woshinamoda/eCon_ArmLet/README.md

## 肌电臂环集合内容（包含老版和新版全部代码与原理图，详细说明请参考项目说明）
### 更新记录
---
更新日期：2022/08/30<br>
 * 1.修改存在的错别字
 * 2.新版臂环和老版臂环分隔开<br>
  本仓库只存储老版本肌电臂环程序与对应内容
---

更新日期：2022/08/29<br>

 * 1.新增修改github上关于肌电臂环梳理内容
 * 2.验证老版本臂环程序matlab内容<br>
  	修改对应老版臂环说明书
	* 详情参考 旧版肌电臂环全部内容<br>
				->重要文档
					—>《肌电臂环说明书V0.0.1》

---

### 项目说明
- doc：内部包含新版本肌电臂环工作计划与讨论的设计开发内容梳理
- Software：新版本肌电臂环程序，基于nrf52832设计
- Hardware：新版本肌电臂环原理图设计
- 旧版本肌电臂环全部内容
	* 1 ：20套肌电臂环单电源测试流程 ： 测试21年10月左右生产的臂环是否有问题
	* 2 : ARMletV0.0.0
	* 3 : ARMletV0.1.1
	* 4 : ARMletV0.1.2
	* 5 : ARMletV1.0.0	：	没有IMU程序
	* 6 : ARMletV1.0.1	：	发给字节跳动带有IMU的程序
	* 7 : BlurTooth_doc	：	飞易通和翌虹的蓝牙模块资料汇总
	* 8 : 肌电臂环生产检测入库文件
	* 9 : 测试流程18套成品肌电臂环
	* 10: matlab离线在线代码
		* 1-> read_data_offline.m ： 离线测试肌电臂环EMG与IMU 信号完整度的测试代码
		* 2-> read_data_online.m  ： 在线观察肌电臂环8个通道RMG与三个方向IMU 信号连续都的测试代码
	* 11: 重要文档
	* 12: read_data.m：用于检测老版本臂环功能的matlab代码
