woshinamoda/eCon_ArmLet/旧版本肌电臂环全部内容/肌电臂环资料(朝旭发的)/资料说明.txt

蓝牙2.0臂带主控板
肌电信号处理电路及PCB-->单个肌电模块电路，主板下的肌电模块电路
程序-->对应“蓝牙2.0臂带主控板”，用的标准库
PCB_SingleSupplyEMG-->最新的单个肌电模块电路，单电源供电
band4.0-->蓝牙4.0主控板和dongle
22、手环新版-->主控板有略微改动，程序用HAL库写了一遍
