woshinamoda/eCon_ArmLet/旧版本肌电臂环全部内容/20套肌电臂环单电源测试流程拟定/臂环测试流程修改3.1/肌电臂环--主板测试流程（GE修改20220224）.docx

# 调试检验规程

产品名称：肌电臂环----控制主板

产品版本：V0.1.4

### 1、 目的

入库检测流程。确保入库时排查出有问题的PCB

### 2、 范围

仅限于版本号：V0.1.4的控制主板


正面：


反面：

### 三、程序烧录

1）.测试控制主板的硬件焊接质量

A. 观察正面与反面，是否有元器件缺焊、漏焊的情况。没有视为正常情况
B. 在焊接的元器件上，观察主控芯片、姿态传感器、二极管、RGB灯充电和LDO芯 片是否存在焊接方向上的问题。与丝印标注一致视为焊接正常情况。对应有极性元 器件标注，如下图所示，红框部分都是需要注意的器件。

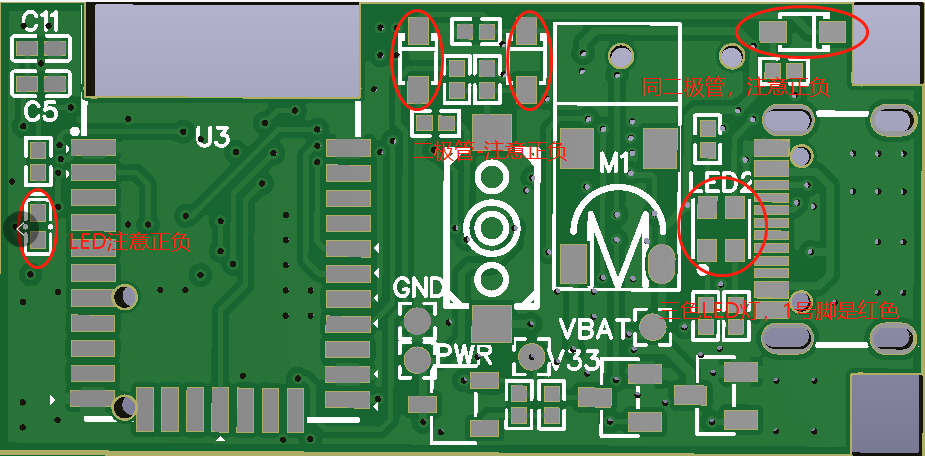
[picture p17: figure]

正面

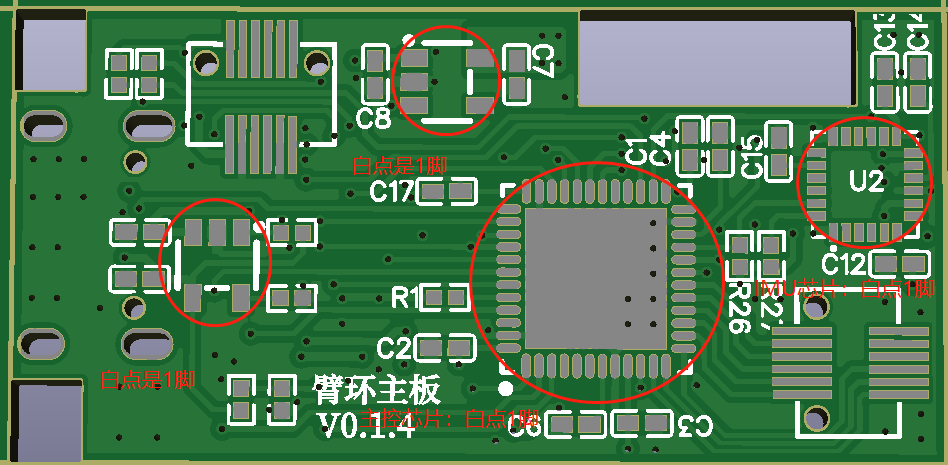
[picture p18: figure]

背面

C. 着重观察板对板连接器有无短路的情况，没有连锡或者短路，视为正常情况。
2） .电压检测
A. 在第一步检测没有短路情况下，控制主板上焊接好电池。电池电压范围在3.7V-4.2V 之间。
B. 长按按键，同时，用万用表测量直流挡点3.3V接入点。如果显示输出位3.3V，则视为正常电源。整体电源部分正常，下面可以写入程序进一步测试
3） 程序烧写
A. 准备一个ST-LINK和USB-TypeC公信号转接板
B. 把信号clk和dio和ST-link连接起来，插入控制主板后，烧入程序。连接后如图所 示。在烧录过程中，需要长按按键，保证LDO的使能引脚处于高电平状态。这样 可以保证MCU的VCC一直处于3.3V状态，可以顺利烧入程序


### 四、 硬件检测步骤

测试条件：在完成程序烧录，初步保证上电工作正常的情况下进行的硬件测试。测试主要验 证带电工作的情况下，元器件都处于正常工作情况。

1） . LED灯检测观察
A. 开机的瞬间，LED（蓝牙指示灯）灯显示蓝色。如果符合条件，视为正常
B. 开机的瞬间，RGB灯会显示白色，如果符合条件，视为正常。显示其他颜色可能是 部分颜色的缺失。
C. 开机后，RGB的颜色会依据当前电池电量显示对应颜色 <3.7V显示红色， ＞3.7V且 小于3.8V显示黄色， 大于3.8V显示蓝色
2） . 震动电机检测
A. 开机时，震动电机会工作200ms。
B. 关机时，震动电机会工作200ms。同时满足上述情况，视为正常。
3） . 充电检测
A. 正常情况下，RGB灯显示当前电量颜色，对应颜色 <3.7V显示红色， ＞3.7V且小于 3.8V显示黄色， 大于3.8V显示蓝色。接入充电器瞬间。蓝牙关闭，RGB灯显示绿 色闪烁状态。
B. 如果电池电压超过4.1V，RGB灯显示绿色常量状态。同时满足上述情况，视为充电 正常

4）. 开机检测

A. 在关机状态下，如果长按按键两秒。控制主板会进入开机提示，随后进入工作状态。
B. 在关机状态下，如果接入充电器。控制主板会进入开机提示，随后进入工作状态。

同时满足上述情况，视开机功能正常

5) . 关机检测
A. 在开机状态下，如果长按按键两秒。控制主板会进入关机提示，随后进入关机状态。
B. 在充电状态下，如果拔掉充电器。控制主板会进入关机提示，随后进入关机状态。

### 五、测试记录报告

小板检测表
方法分类 | 序号 | 内容 | 检测结果
焊接检测 | 1 | 有无缺焊、漏焊的情况
| 2 | 有无短路、焊接错误、元器件损坏或者翘起来的情况
| 3 | 有极性元器件是否方向摆放错误
| 4 | 板对板元器件确认是否焊接正常
电压测试 | 1 | 3.3V是否输出正常
| 2 | 充电时，5V接入和VBAT输出是否正常
程序测试 | 1 | LED与RGB状态是否正常
| 2 | 震动电机检测是否正常
| 3 | 充电检测是否正常
| 4 | 开机检测是否正常
| 5 | 关机检测是否正常
