woshinamoda/eCon_ArmLet/旧版本肌电臂环全部内容/肌电臂环资料(朝旭发的)/Newarm/线路图.pptx

Amp底板

Amplifier

3.3V转-Vs

板对板连接器

3.3V

3.7V

V1234 678

主板

3.7V转3.3V

3.7V充电

电池

Amplifier

3.7V

3.3V

-Vs

V1234 678
