woshinamoda/eCon_ArmLet/旧版本肌电臂环全部内容/重要文档/版本说明.docx

V0.1.1:

双电源原始版本

V0.1.2：

新增串口指令

0xCC 0xDD + 0xFF 0x66 //开启IMU读取

0xCC 0xDD + 0xFF 0x77 //关闭IMU读取

例如：/* CCDDFF66 开启读取IMU*/

0xCC 0xDD + 0xEE time //开启一次电机震动

//震动时间 time x 100(ms),time 1个字节时间

0 - 255

例如：/* CCDDEE03 震动300毫秒*/

V1.0.0:

更换蓝牙 EH-M17(舍去)，用BT966/BT986代替
