woshinamoda/eCon_ArmLet/旧版本肌电臂环全部内容/重要文档/臂环图.docx

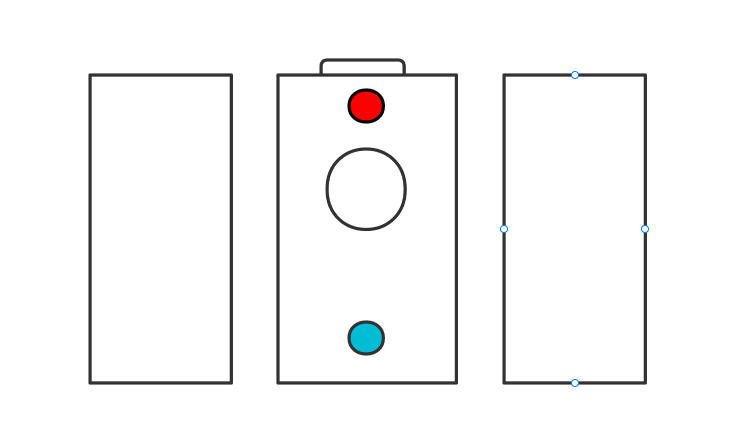
[picture p29: figure]

图5-1

j

i

h

g
