woshinamoda/eCon_ArmLet/旧版本肌电臂环全部内容/20套肌电臂环单电源测试流程拟定/臂环测试流程修改3.1/肌电臂环--小板测试流程（GE修改20220224）.docx

# 调试检验规程

产品名称：肌电臂环----采集小板

产品版本：V0.1.2

## 一、目的

入库检测流程。确保入库时排查出有问题的PCB

## 二、范围

仅限于版本号：V0.1.2的采集小板


接入测试点说明

1. 电池GND : 电池接入的负极
2. 电池输入+ : 电池接入的正极
3. GND测试点 : 引出的PCB的GND，方便电源信号测试
4. 3.3V接入点 : 运放供电输入，输入范围≤5V，测试时可用电池代替3.3V接入供电
5. 信号测试点 : 测试肌电信号

### 3、 测试步骤

1） .观察采集小板硬件焊接质量
A. 没有少元器件，没有漏焊的情况（注：NC处不用焊接）
B. 焊接的元器件没有翘起来、没有短路的情况
C. 正面两颗运放AD8607和INA826AIDR的1脚没有焊接反的情况。1脚标明如图所示红色方框处

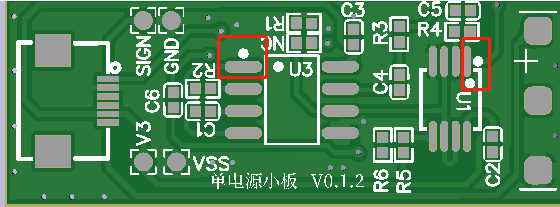
[picture p38: figure]

D. 反面的三个金属触电需要注意，有没有焊接不正的情况。如果明显可以看到有银白色焊盘露出，说明焊接不正。这种情况视为焊接失败。
2） .测试采集小板电路电压
A. 先用万用表蜂鸣挡测量GND与电池输入+、3.3V接入、信号测试点有无短路
B. 在执行完A且正常的情况下，测试员需要将电池的正极引线和3.3V接入点的测试焊盘焊接在一起，将电池的负极引线和GND测试点焊盘焊接在一起。为后面信号测试做准备。
3） .信号质量检测
A. 测试员将测试PCB的信号测试点与GND测试点用线焊接引出，与示波器相连接。如下图，GND引出线连接探头地，信号测试引出线连接探针夹处，如下图所示。


B. 测试PCB的底部金属用酒精擦拭，同时测试人员露出手臂，擦拭酒精。将金属部分和测试人员手臂紧密接触，用示波器观察波形。
1. 波形会有个直流基准电压，该电压电压值为二分之一的电池电压
2. 贴到手臂时，会有一个生物电波形。如果手臂处于静止状态，这个波形也稳定 的，没有过多的幅值变化。如下图所示

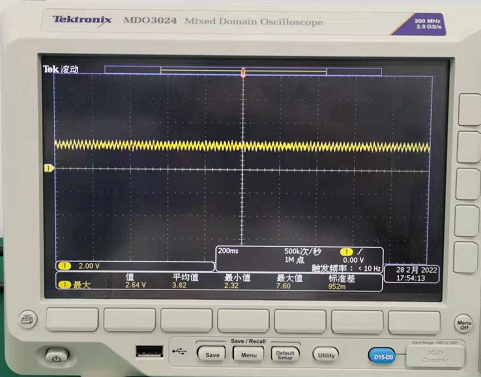
[picture p39: figure]

C. 随后测试人员请执行握拳，翻腕，伸张手掌等动作。观察有没有对应肌电波形产生。

波形如下图红圈部分所示。会有对应的动作电位波形产生。

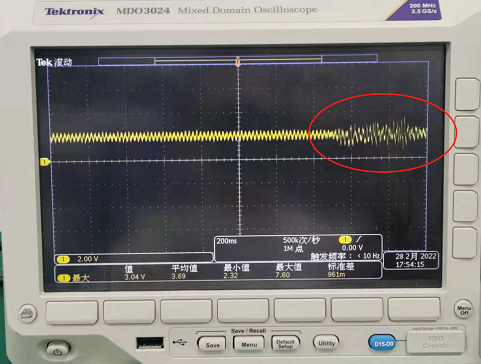
[picture p40: figure]

### 四、测试记录报告

小板检测表
方法分类 | 序号 | 内容 | 检测结果
焊接检测 | 1 | 有无缺焊、漏焊
| 2 | 有无短路、焊错、元器件损坏或翘起来
| 3 | 有极性元器件是否方向错误
| 4 | 关键元器(金属触电)件有无焊接不正的情况
电压测试 | 1 | 测试点有没有与GND短路的情况
信号测试 | 1 | 没有信号时观察波形，是否是直流VCC/2的电压。 如果是，说明运放工作正常。
| 2 | 采集信号是否正常，是否符合动作触发。符合触发视为采集工作正常
