woshinamoda/eCon_ArmLet/旧版本肌电臂环全部内容/臂环生产检测入库文件/肌电臂环主板BOOM清单.csv

ID | Name | Designator | Footprint | Quantity | Manufacturer Part | Manufacturer | Supplier | Supplier Part | Price
1 | MPU-6050_C24112 | U2 | QFN-24_L4.0-W4.0-P0.50-BL-MPU-6050 | 1 | MPU-6050 | InvenSense | LCSC | C24112 | 31.58
2 | 10k | R14,R19,R20,R24,R50 | R0402 | 5 | RT0402FRD0710KL | YAGEO | LCSC | C723584 | 0.0801
3 | 1uf | C17,C7,C8 | C0402_NEW | 3 | CL05B104KO5NNNC | SAMSUNG | LCSC | C1525 | 0.0068
4 | RT9013-12GB | U6 | SOT-23-5_L3.0-W1.7-P0.95-LS2.8-BR | 1 | RT9013-12GB | RICHTEK | LCSC | C58464 | 1.4209
5 | 104 | C1,C3,C6,C12,C13,C14,C2,C5 | C0402_NEW | 8 | CL05B104KO5NNNC | SAMSUNG | LCSC | C1525 | 0.0068
6 | 2.2uf | C4,C15 | C0402_NEW | 2 | CL05B104KO5NNNC | SAMSUNG | LCSC | C1525 | 0.0068
7 | 10kΩ | R1,R26,R27,R3,R15 | R0402 | 5 | RT0402FRD0710KL | YAGEO | LCSC | C723584 | 0.0801
8 | 2K | R7,R13 | R0402 | 2 | RT0402FRD0710KL | YAGEO | LCSC | C723584 | 0.0801
9 | STM32F411CEU6 | U1 | UFQFPN-48_L7.0-W7.0-P0.50-BL-EP | 1 | STM32F411CEU6 | STMicroelectronics | LCSC | C60420 | 38.78
10 | MCP73831T-2ACI/OT | U4 | SOT-23-5_L3.0-W1.7-P0.95-LS2.8-BR | 1 | MCP73831T-2ACI/OT | Microchip Tech | LCSC | C424093 | 7.94
11 | Header 12 | P1,P2 | BTB0.5*2*6BOTTOM | 2
12 | 4.7uf | C9,C10 | C0402_NEW | 2 | CL05B104KO5NNNC | SAMSUNG | LCSC | C1525 | 0.0068
13 | 20k | R16,R23 | R0402 | 2 | RT0402FRD0710KL | YAGEO | LCSC | C723584 | 0.0801
14 | 1.2mm测试点 | GND,PWR,V33,VBAT | 1.2毫米测试点 | 4
15 | BL-HB337A-AV-TRB | LED1 | LED0402-RD | 1 | BL-HB337A-AV-TRB | BrtLed | LCSC | C165977 | 0.1896
16 | FM-B2020RGBA-HG | LED2 | LED-SMD_FM-B2020RGBA-HG | 1 | FM-B2020RGBA-HG | NATIONSTAR | LCSC | C108793 | 0.1843
17 | 510ohm | R2 | R0402 | 1 | RT0402FRD0710KL | YAGEO | LCSC | C723584 | 0.0801
18 | FSC-BT982 | U3 | WIFI-SMD_FAKRAZ180 | 1 | FSC-BT982 | null | LCSC | C9900002352
19 | 1N4148WS T4 | D3,D1,D2 | SOD-323_L1.8-W1.3-LS2.5-RD | 3 | 1N4148WS T4 | CJ | LCSC | C2128 | 0.1045
20 | 1M | R5 | R0402 | 1 | RT0402FRD0710KL | YAGEO | LCSC | C723584 | 0.0801
21 | NPN | Q3,Q1 | SOT-23-3_L2.9-W1.3-P1.90-LS2.4-BR | 2 | DTC143ZCA | CJ | LCSC | C15236 | 0.1601
22 | PMOS | Q2 | SOT-23-3_L2.9-W1.6-P1.90-LS2.8-BR | 1 | BLM3401 | BL | LCSC | C90479 | 0.4747
23 | 106 | C11 | C0402_NEW | 1 | CL05B104KO5NNNC | SAMSUNG | LCSC | C1525 | 0.0068
24 | 510 | R21,R22,R25,R29 | R0402 | 4 | RT0402FRD0710KL | YAGEO | LCSC | C723584 | 0.0801
25 | KH-TYPE-C-16P | USB1 | USB-C-SMD_KH-TYPE-C-16P | 1 | KH-TYPE-C-16P | Shenzhen Kinghelm Elec | LCSC | C709357 | 0.5965
26 | KEY | SW1 | KEY-SMD_L6.2-W3.6-LS8.0 | 1 | K2-1107ST-A4SW-06 | Rectangular Connectors - Contacts | LCSC | C118141 | 0.4502
27 | MOTOR | M1 | MOTOR | 1
