woshinamoda/eCon_ArmLet/旧版本肌电臂环全部内容/肌电臂环资料(朝旭发的)/Newarm/HandBand_HW/HW2.0/band4.1.dxf

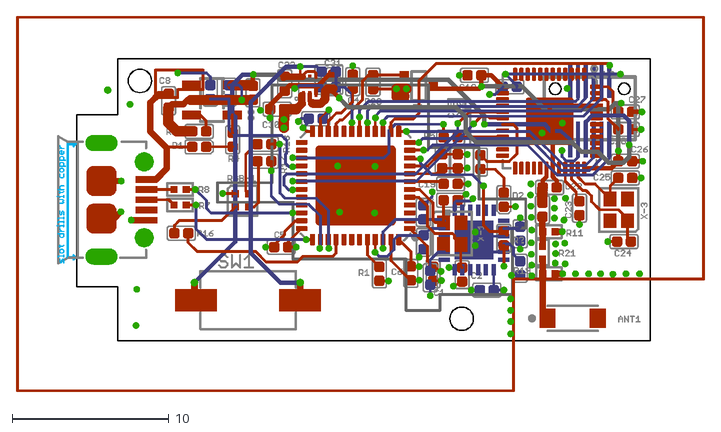
[picture p45: CAD file, 2022-08-29, an earlier design]
旧版本肌电臂环全部内容/肌电臂环资料(朝旭发的)/Newarm/HandBand_HW/HW2.0/band4.1.dxf
44.0 x 24.0
