woshinamoda/eCon_ArmLet/旧版本肌电臂环全部内容/肌电臂环资料(朝旭发的)/肌电信号处理电路及PCB/肌电信号处理电路及PCB/PCB finished/testing.PcbDoc.htm

Reporting Options

# File in Previous Format

Date | : | 2020-03-25
Time | : | 15:06:13
Filename | : | F:\DeskManager\2、手环程序+硬件\肌电信号处理电路及PCB\肌电信号处理电路及PCB\PCB finished\testing.PcbDoc

Version | Warning
Release 12 | CAUTION - Air Gap Width previously controlled by Clearance rule is now controlled by Polygon Connect Style rule's newly introduced Air Gap Width (set to default value). Suggest reviewing each Polygon Connect Style rule's Air Gap Width attribute for correctness.
Release 13 | CAUTION - Silkscreen Over Component Pads Rules are converted to Silk To Solder Mask Clearance Rules. Suggest examining rule scopes for accuracy.

This file was generated by an earlier version of the software
