woshinamoda/eCon_ArmLet/旧版本肌电臂环全部内容/肌电臂环资料(朝旭发的)/程序/日志.txt

20170305:
目标：本工程实现mpu上的dmp读取和四元数解算
20170312：
已基本实现读取和四元数的读取，现有算法能实现
实现四元素和欧拉角的转换
现存问题：mpu的响应较慢，即得到正确的欧拉角要很长时间
20170426:
1）发现了mpu9150读空的现象，导致数据不连续的问题
