woshinamoda/eCon_ArmLet/旧版本肌电臂环全部内容/肌电臂环资料(朝旭发的)/肌电信号处理电路及PCB/肌电信号处理电路及PCB/testing/testing.pdf

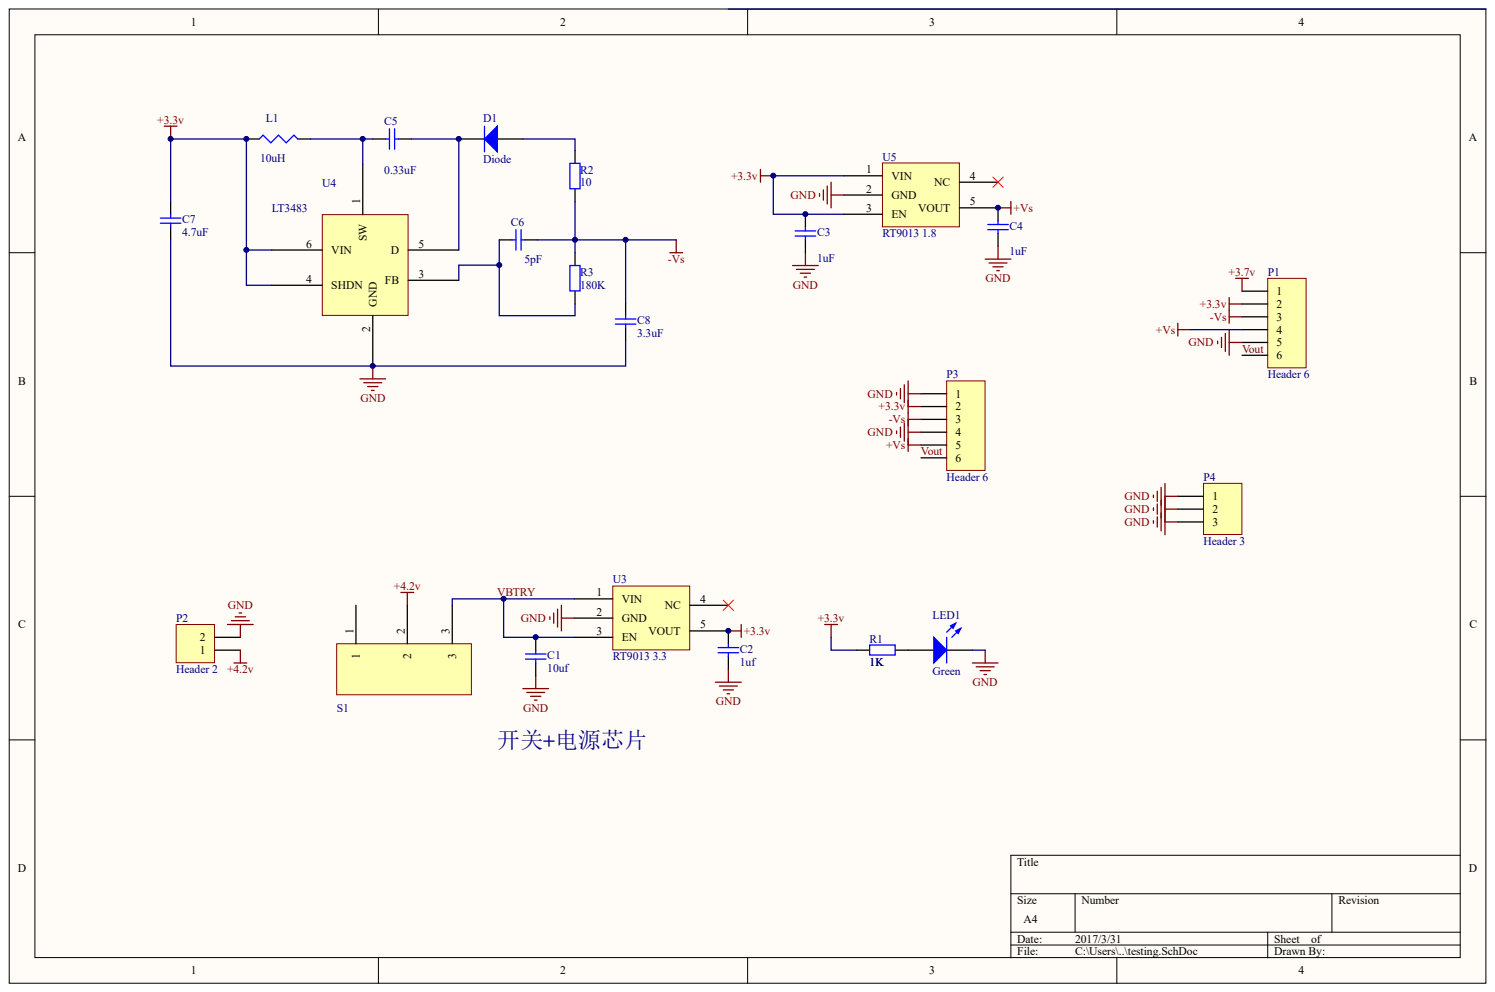
[picture p46: page 1]

GND 2
EN 3
