woshinamoda/eCon_ArmLet/旧版本肌电臂环全部内容/肌电臂环资料(朝旭发的)/band4.0-蓝牙的主从/slave/band4.0.pdf

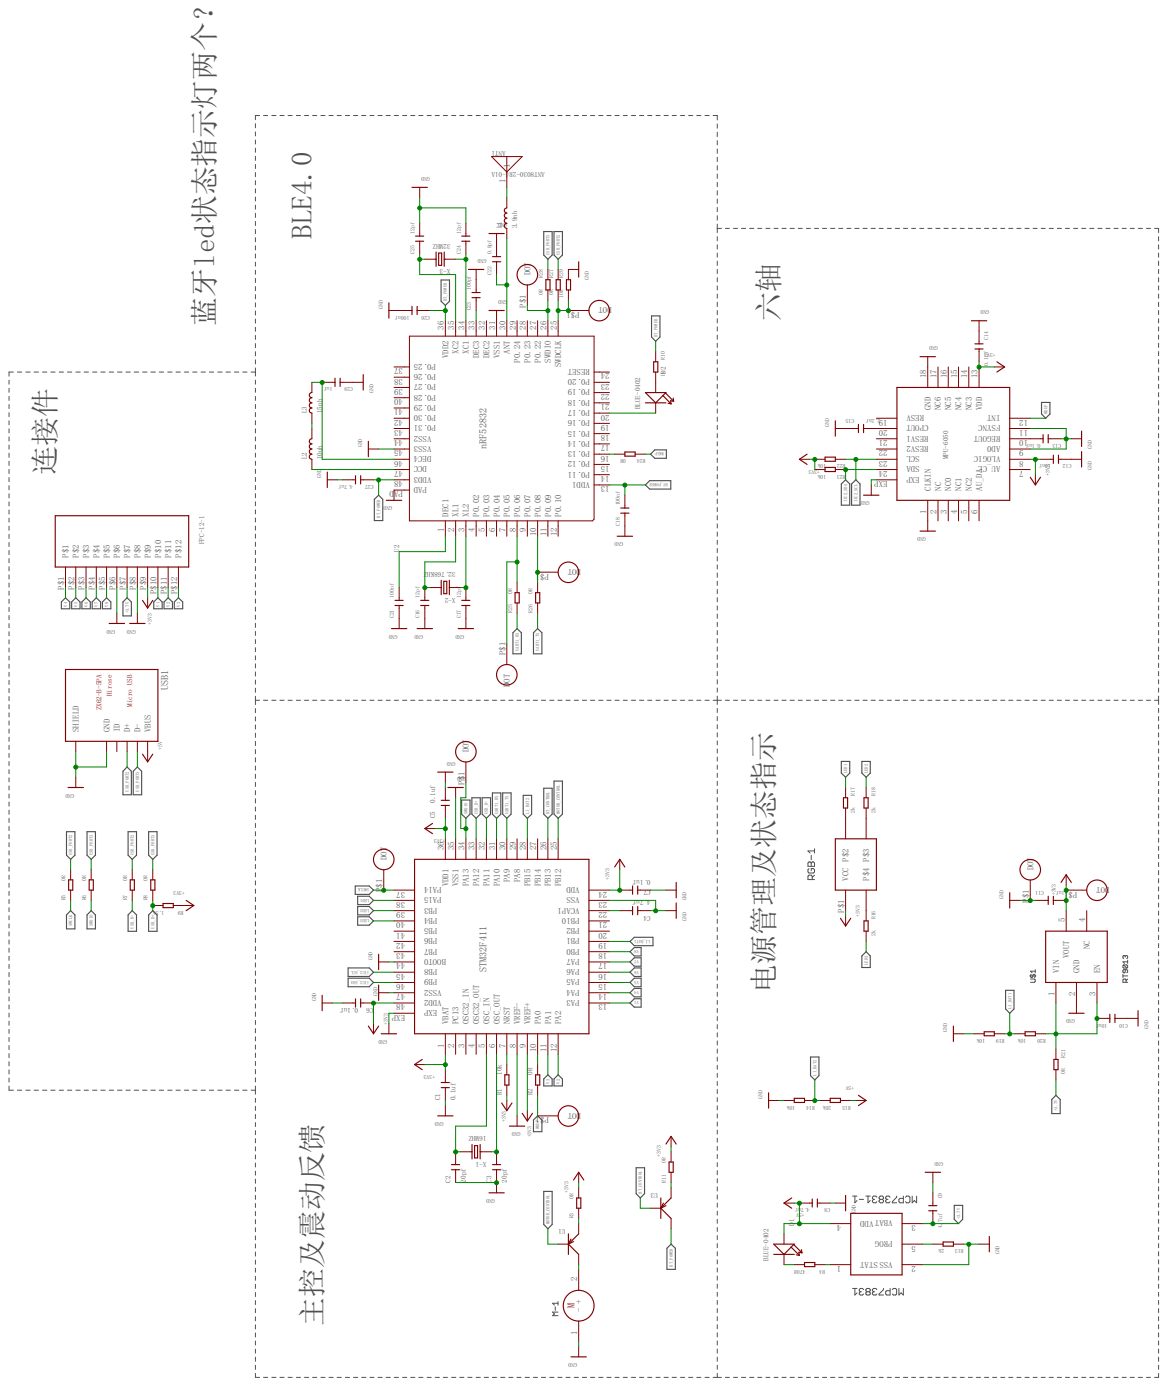
[picture p47: page 1]

主控及震动反馈 电源管理及状态指示 六轴 蓝牙led状态指示灯两个？ BLE4.0 连接件 STM32F411 MPU-6050 nRF52832 0.1uf 20pf 20pf fu7.4 0.1uf fu1.0 ZHM61 DNG DNG DNG DNG GND GND 3V3+ +3V3 +3V3 3V3+ +3V3 10k 0R 0R fu1.0 DNG GND GND GND +3V3 DNG +3V3 DNG BLUE-0402 R074 V5+ fu7.4 GND GNk2 D 4.7uf DNG k01 k02 GND V5+ +3V3 2k 2k2k k01 k01 0R GND DNG fu01 GND fu1 GND+3V3 BLUE-0402 fn01 fu1.0 0.1uf fn2.2 k01 k01 DNG DNG +3V3GND GND DNG3V3+ DNG GND 3V3+ 12pf 12pf 100nf 100nf ZHK867.23 R0 0R0R DNG DNG DNG DNG 0R0R 10k 0.8pf 100pf 12pf 12pf fn001 GND 3.9nh 10uh 15nh A10-4R2-0308TNA DNG DNG DNG ZHM23 GND DNG fu7.4 GND DNG fu1 GND GND DNG DNG +3V3 +5V DNG 0R0R0R0R k5.1 3V3+ +3V3 1k 0R VBAT 1 PC13 2 OSC32_IN 3 OSC32_OUT 4 OSC_IN 5 OSC_OUT 6 NRST 7 VREF- 8 VREF+ 9 PA0 10 PA1 11 PA2 12 3AP 31 4AP 41 5AP 51 6AP 61 7AP 71 0BP 81 1BP 91 2BP 02 01BP 12 1PACV 22 SSV 32 DDV 42 PB12 25 PB13 26 PB14 27 PB15 28 PA8 29 PA9 30 PA10 31 PA11 32 PA12 33 PA13 34 VSS1 35 VDD1 36 41AP 73 51AP 83 3BP 93 4BP 04 5BP 14 6BP 24 7BP 34 0TOOB 44 8BP 54 9BP 64 2SSV 74 2DDV 84 PXE PXE C1 C2C3 4C C5 6C 1-X R1R2 R3 7C - 1 + 2 1U TATS 1 SSV 2 TABV 3 DDV 4 GORP 5 VIN 1 GND 2 EN 3 NC 4 VOUT 5 VCC P$1 P$2 P$3 P$4 D1 4R8C 31R C9 41R 51R R16 R17 R18 91R 02R R21 01C 11C D2 CLKIN 1 NC 2 NC0 3 NC1 4 NC2 5 AU_DA 6 LC_UA 7 CIGOLV 8 0DA 9 TUOGER 01 CNYSF 11 TNI 21 VDD 13 NC3 14 NC4 15 NC5 16 NC6 17 GND 18 VSER 91 TUOPC 02 1VSER 12 2VSER 22 LCS 32 ADS 42 PXE PXE 21C 31C C14 51C 22R 32R 72.0P 93 XL1 2 XL2 3 P0.23 28 P0.22 27 P0.02 4 P0.03 5 P0.04 6 P0.05 7 P0.06 8 P0.07 9 TESER 42 1DDV 31 P0.08 10 P0.09 11 P0.10 12 11.0P 41 21.0P 51 31.0P 61 41.0P 71 51.0P 81 61.0P 91 SWDIO 26 SWDCLK 25 71.0P 02 81.0P 12 91.0P 22 02.0P 32 P0.24 29 ANT 30 VSS1 31 DEC2 32 DEC3 33 52.0P 73 62.0P 83 VDD2 36 XC1 34 XC2 35 DEC1 1 DAP DAP 82.0P 04 92.0P 14 03.0P 24 13.0P 34 2SSV 44 3SSV 54 4CED 64 CCD 74 3DDV 84U2 C16 C17 C18 C21 2-X 42R R25 R26 R27 R28 R29C22 C23 C24 C25 62C L1 L2 L3 1 1 1TNA 3-X 72C 82C P$1 P$1 P$2 P$2 P$3 P$3 P$4 P$4 P$5 P$5 P$6 P$6 P$7 P$7 P$8 P$8 P$9 P$9 P$10 P$10 P$11 P$11 P$12 P$12 FPC-12-1 USB1 VBUS D-D+IDGND SHIELD R5R6R7R8 9R DOT P$1 DOT P$1 TOD 1$P TOD 1$P DOT P$1 DOT P$1 TOD 1$P TOD 1$P DOT P$1 3U R10 R11 WKUP WKUP PUKW V3 V3 V2 V2 1V V1 4V V4 5V V5 6V V6 7V V7 8V V8 1TAB_IL LI_BAT1 MOTOR_CONTROL MOTOR_CONTROL LI_BAT2 LI_BAT2 UART1_TX UART1_TX UART1_RX UART1_RX USB_D- USB_D- USB_D+ USB_D+ SWDIO SWDIO KLCWS SWCLK 1DEL LED1 2DEL LED2 3DEL LED3 LCS_2CII IIC2_SCL ADS_2CII IIC2_SDA +3.7V +3.7V +3.7V REWOP_TB BT_POWER BT_POWER BT_POWER BT_POWER USB_PORT2 USB_PORT2 USB_PORT2 USB_PORT2 USB_PORT3 USB_PORT3 USB_PORT3 USB_PORT3 BT_CONTROL BT_CONTROL M Micro USB Hirose ZX62-B-5PA
