woshinamoda/eCon_ArmLet/旧版本肌电臂环全部内容/肌电臂环资料(朝旭发的)/蓝牙2.0臂带主控板/Alpha-1.pdf

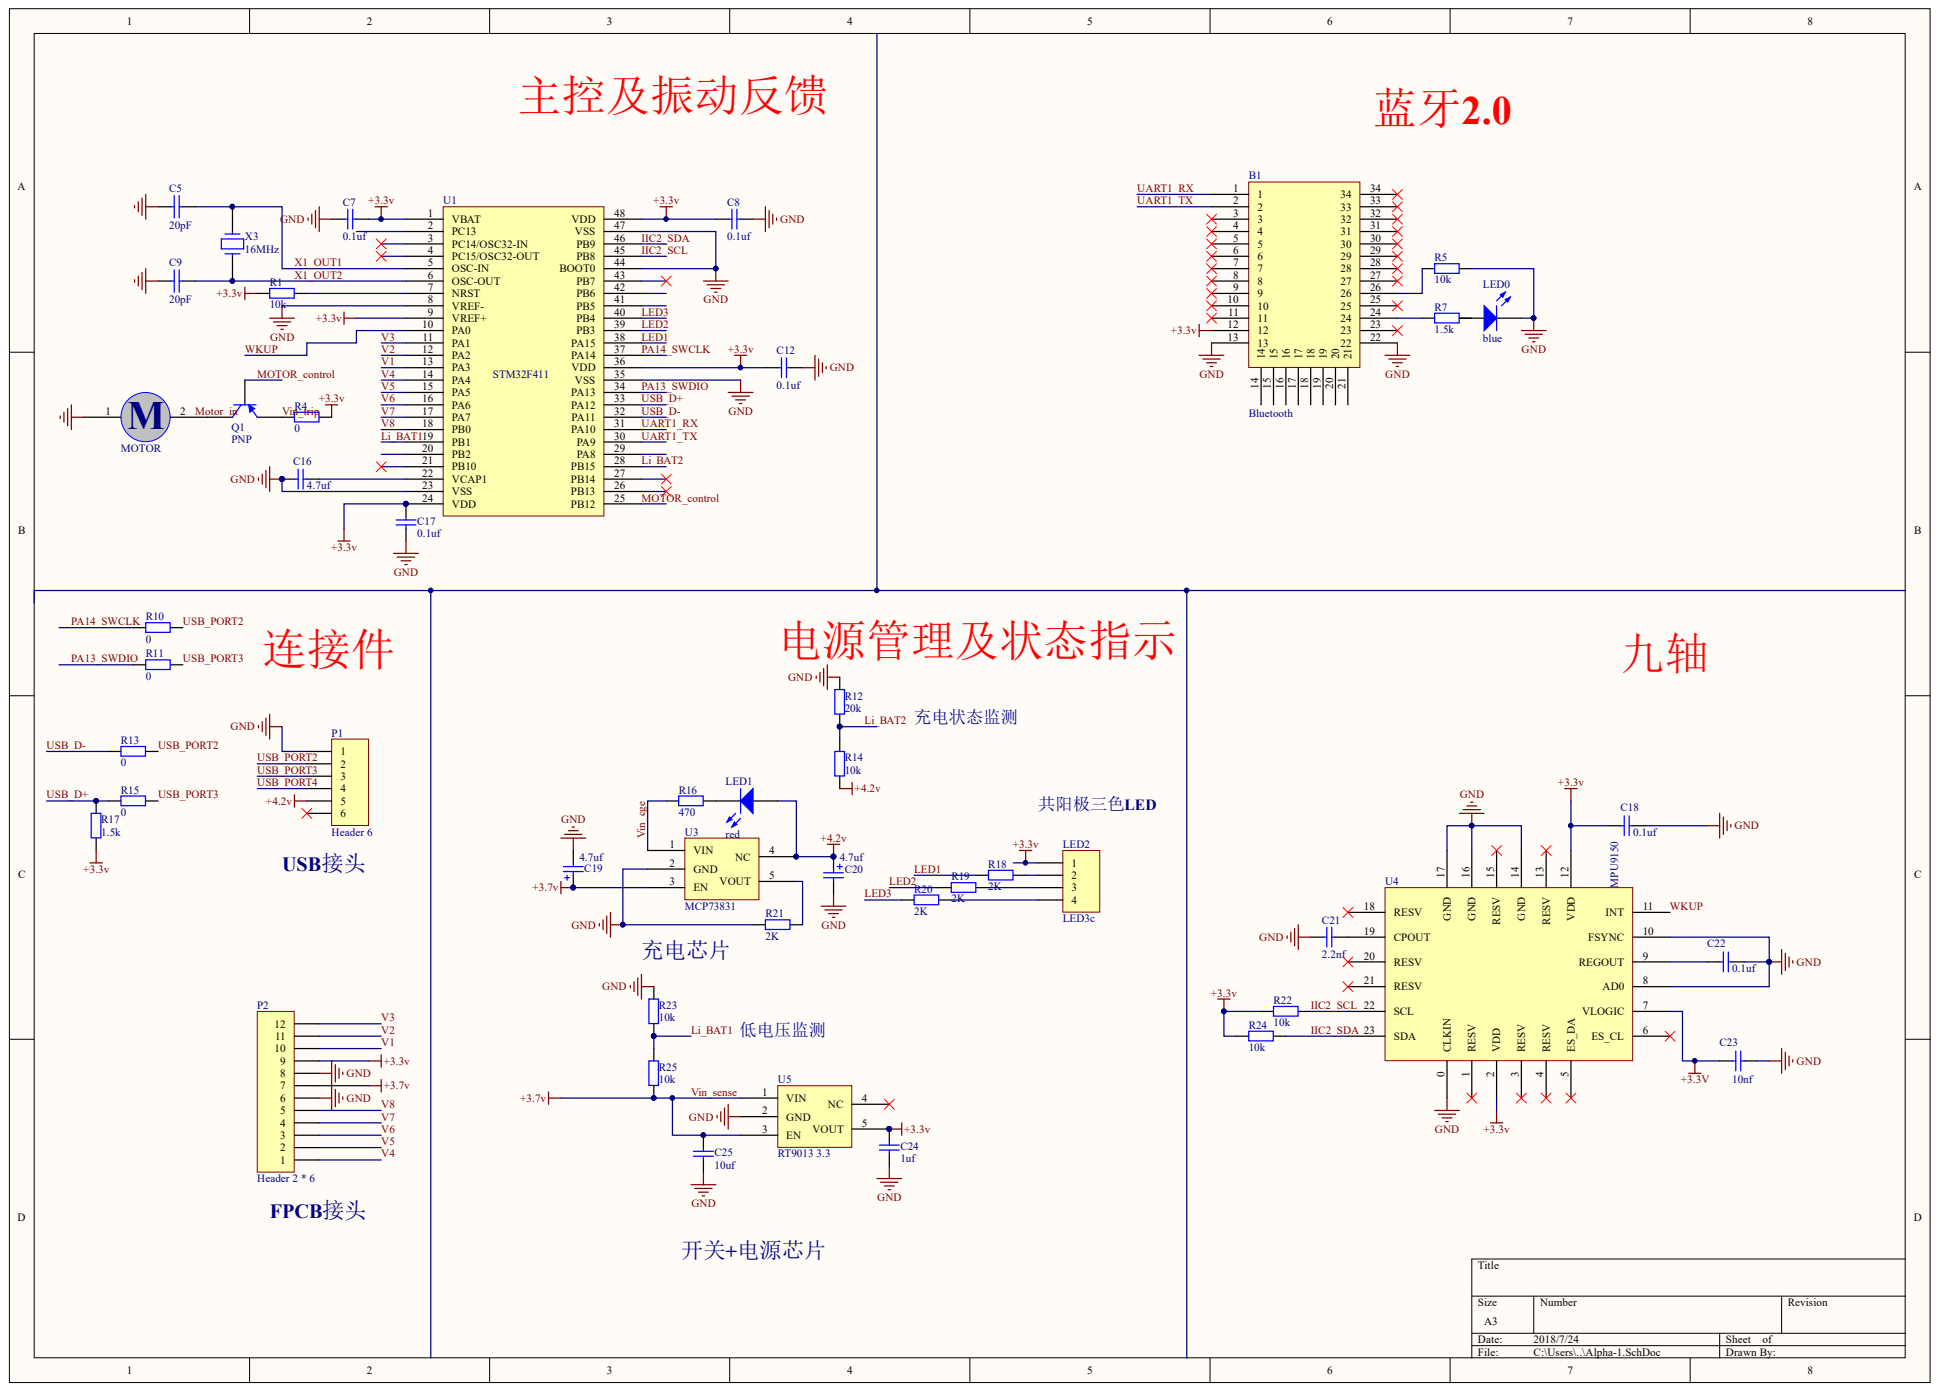
[picture p48: page 1]
