woshinamoda/eCon_ArmLet/旧版本肌电臂环全部内容/肌电臂环资料(朝旭发的)/band4.0-蓝牙的主从/host/host.pdf

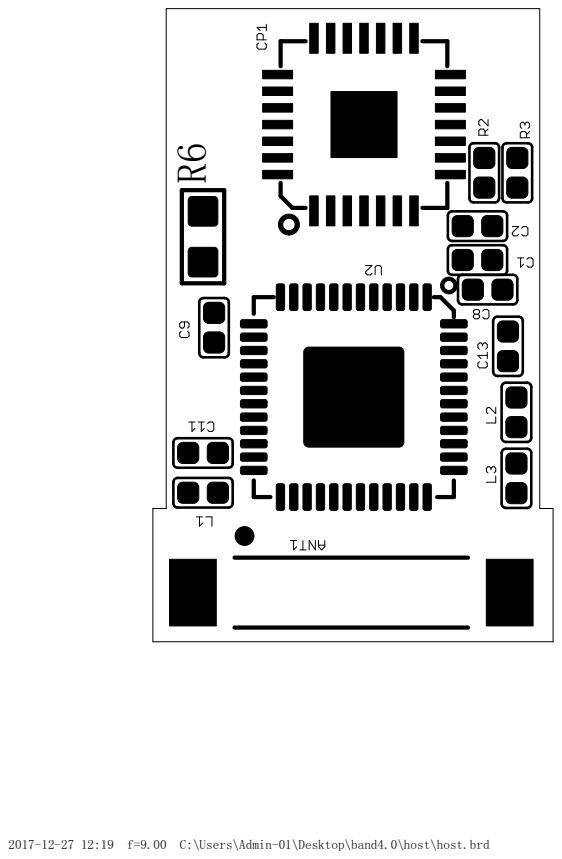
[picture p49: page 1]

2017-12-27 12:19 f=9.00 C:\Users\Admin-01\Desktop\band4.0\host\host.brd
