woshinamoda/eCon_ArmLet/旧版本肌电臂环全部内容/肌电臂环资料(朝旭发的)/肌电信号处理电路及PCB/肌电信号处理电路及PCB/amplifier/amplifier.pdf

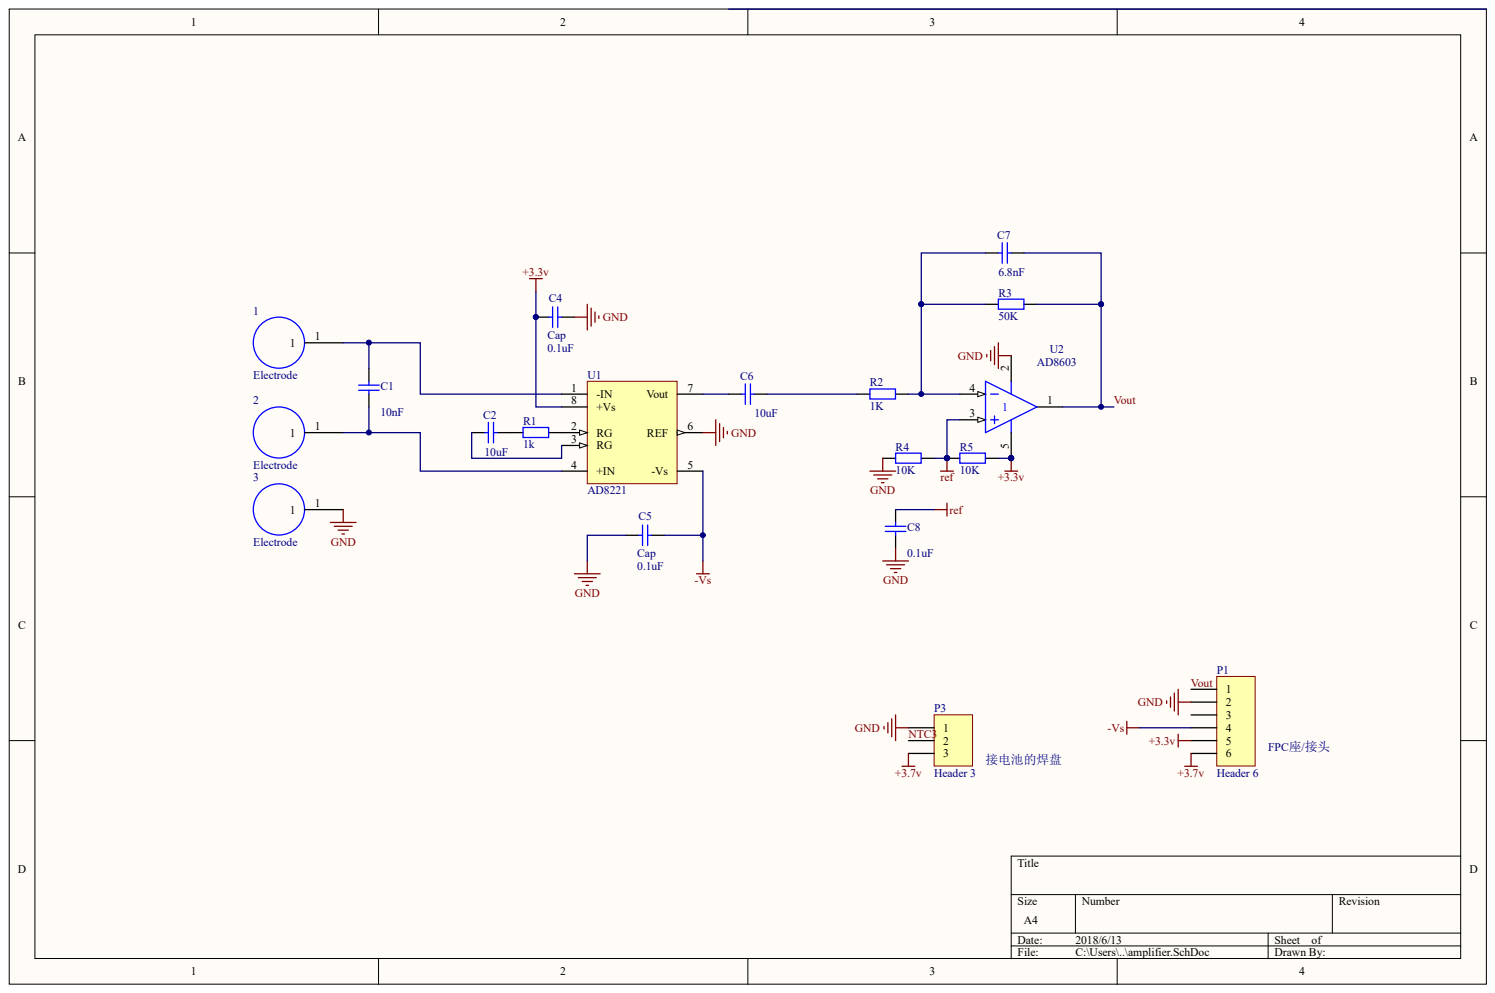
[picture p50: page 1]
