woshinamoda/eCon_ArmLet/(list of files, drawings)

Other design files:
旧版本肌电臂环全部内容/肌电臂环资料(朝旭发的)/肌电信号处理电路及PCB/肌电信号处理电路及PCB/amplifier sp/amplifier sp ref.PcbDoc
旧版本肌电臂环全部内容/肌电臂环资料(朝旭发的)/肌电信号处理电路及PCB/肌电信号处理电路及PCB/amplifier sp/amplifier sp.PcbDoc
旧版本肌电臂环全部内容/肌电臂环资料(朝旭发的)/肌电信号处理电路及PCB/肌电信号处理电路及PCB/amplifier sp/amplifier sp.PrjPCB
旧版本肌电臂环全部内容/肌电臂环资料(朝旭发的)/肌电信号处理电路及PCB/肌电信号处理电路及PCB/amplifier sp/amplifier sp.SchDoc
旧版本肌电臂环全部内容/肌电臂环资料(朝旭发的)/肌电信号处理电路及PCB/肌电信号处理电路及PCB/amplifier/amplifier1.PcbLib
旧版本肌电臂环全部内容/肌电臂环资料(朝旭发的)/肌电信号处理电路及PCB/肌电信号处理电路及PCB/amplifier/amplifier2.PcbLib
旧版本肌电臂环全部内容/肌电臂环资料(朝旭发的)/肌电信号处理电路及PCB/肌电信号处理电路及PCB/amplifier/amplifier3.PcbLib
旧版本肌电臂环全部内容/肌电臂环资料(朝旭发的)/肌电信号处理电路及PCB/肌电信号处理电路及PCB/amplifier/amplifier.PcbDoc
旧版本肌电臂环全部内容/肌电臂环资料(朝旭发的)/肌电信号处理电路及PCB/肌电信号处理电路及PCB/amplifier/amplifier.PcbLib
旧版本肌电臂环全部内容/肌电臂环资料(朝旭发的)/肌电信号处理电路及PCB/肌电信号处理电路及PCB/amplifier/amplifier.PrjPCB
旧版本肌电臂环全部内容/肌电臂环资料(朝旭发的)/肌电信号处理电路及PCB/肌电信号处理电路及PCB/amplifier/amplifier.SchDoc
旧版本肌电臂环全部内容/肌电臂环资料(朝旭发的)/肌电信号处理电路及PCB/肌电信号处理电路及PCB/PCB finished/amplifier sp.PcbDoc
旧版本肌电臂环全部内容/肌电臂环资料(朝旭发的)/肌电信号处理电路及PCB/肌电信号处理电路及PCB/PCB finished/amplifier.PcbDoc
旧版本肌电臂环全部内容/肌电臂环资料(朝旭发的)/肌电信号处理电路及PCB/肌电信号处理电路及PCB/PCB finished/testing.PcbDoc
旧版本肌电臂环全部内容/肌电臂环资料(朝旭发的)/肌电信号处理电路及PCB/肌电信号处理电路及PCB/testing/PCB_Project1.PrjPCB
旧版本肌电臂环全部内容/肌电臂环资料(朝旭发的)/肌电信号处理电路及PCB/肌电信号处理电路及PCB/testing/testing.PcbDoc
旧版本肌电臂环全部内容/肌电臂环资料(朝旭发的)/肌电信号处理电路及PCB/肌电信号处理电路及PCB/testing/testing.SchDoc
旧版本肌电臂环全部内容/肌电臂环资料(朝旭发的)/肌电信号处理电路及PCB/肌电信号处理电路及PCB/有线肌电模块/amp.PcbDoc
旧版本肌电臂环全部内容/肌电臂环资料(朝旭发的)/肌电信号处理电路及PCB/肌电信号处理电路及PCB/有线肌电模块/amp.PcbLib
旧版本肌电臂环全部内容/肌电臂环资料(朝旭发的)/肌电信号处理电路及PCB/肌电信号处理电路及PCB/有线肌电模块/amp.SchDoc
旧版本肌电臂环全部内容/肌电臂环资料(朝旭发的)/蓝牙2.0臂带主控板/Alpha-1.PcbDoc
旧版本肌电臂环全部内容/肌电臂环资料(朝旭发的)/蓝牙2.0臂带主控板/Alpha-1.PcbLib
旧版本肌电臂环全部内容/肌电臂环资料(朝旭发的)/蓝牙2.0臂带主控板/Alpha-1.SchDoc
