woshinamoda/eCon_ArmLet/旧版本肌电臂环全部内容/肌电臂环资料(朝旭发的)/band4.0-蓝牙的主从/slave/band4.0.brd

## EAGLE design 旧版本肌电臂环全部内容/肌电臂环资料(朝旭发的)/band4.0-蓝牙的主从/slave/band4.0.brd (2022-08-29, an earlier design)

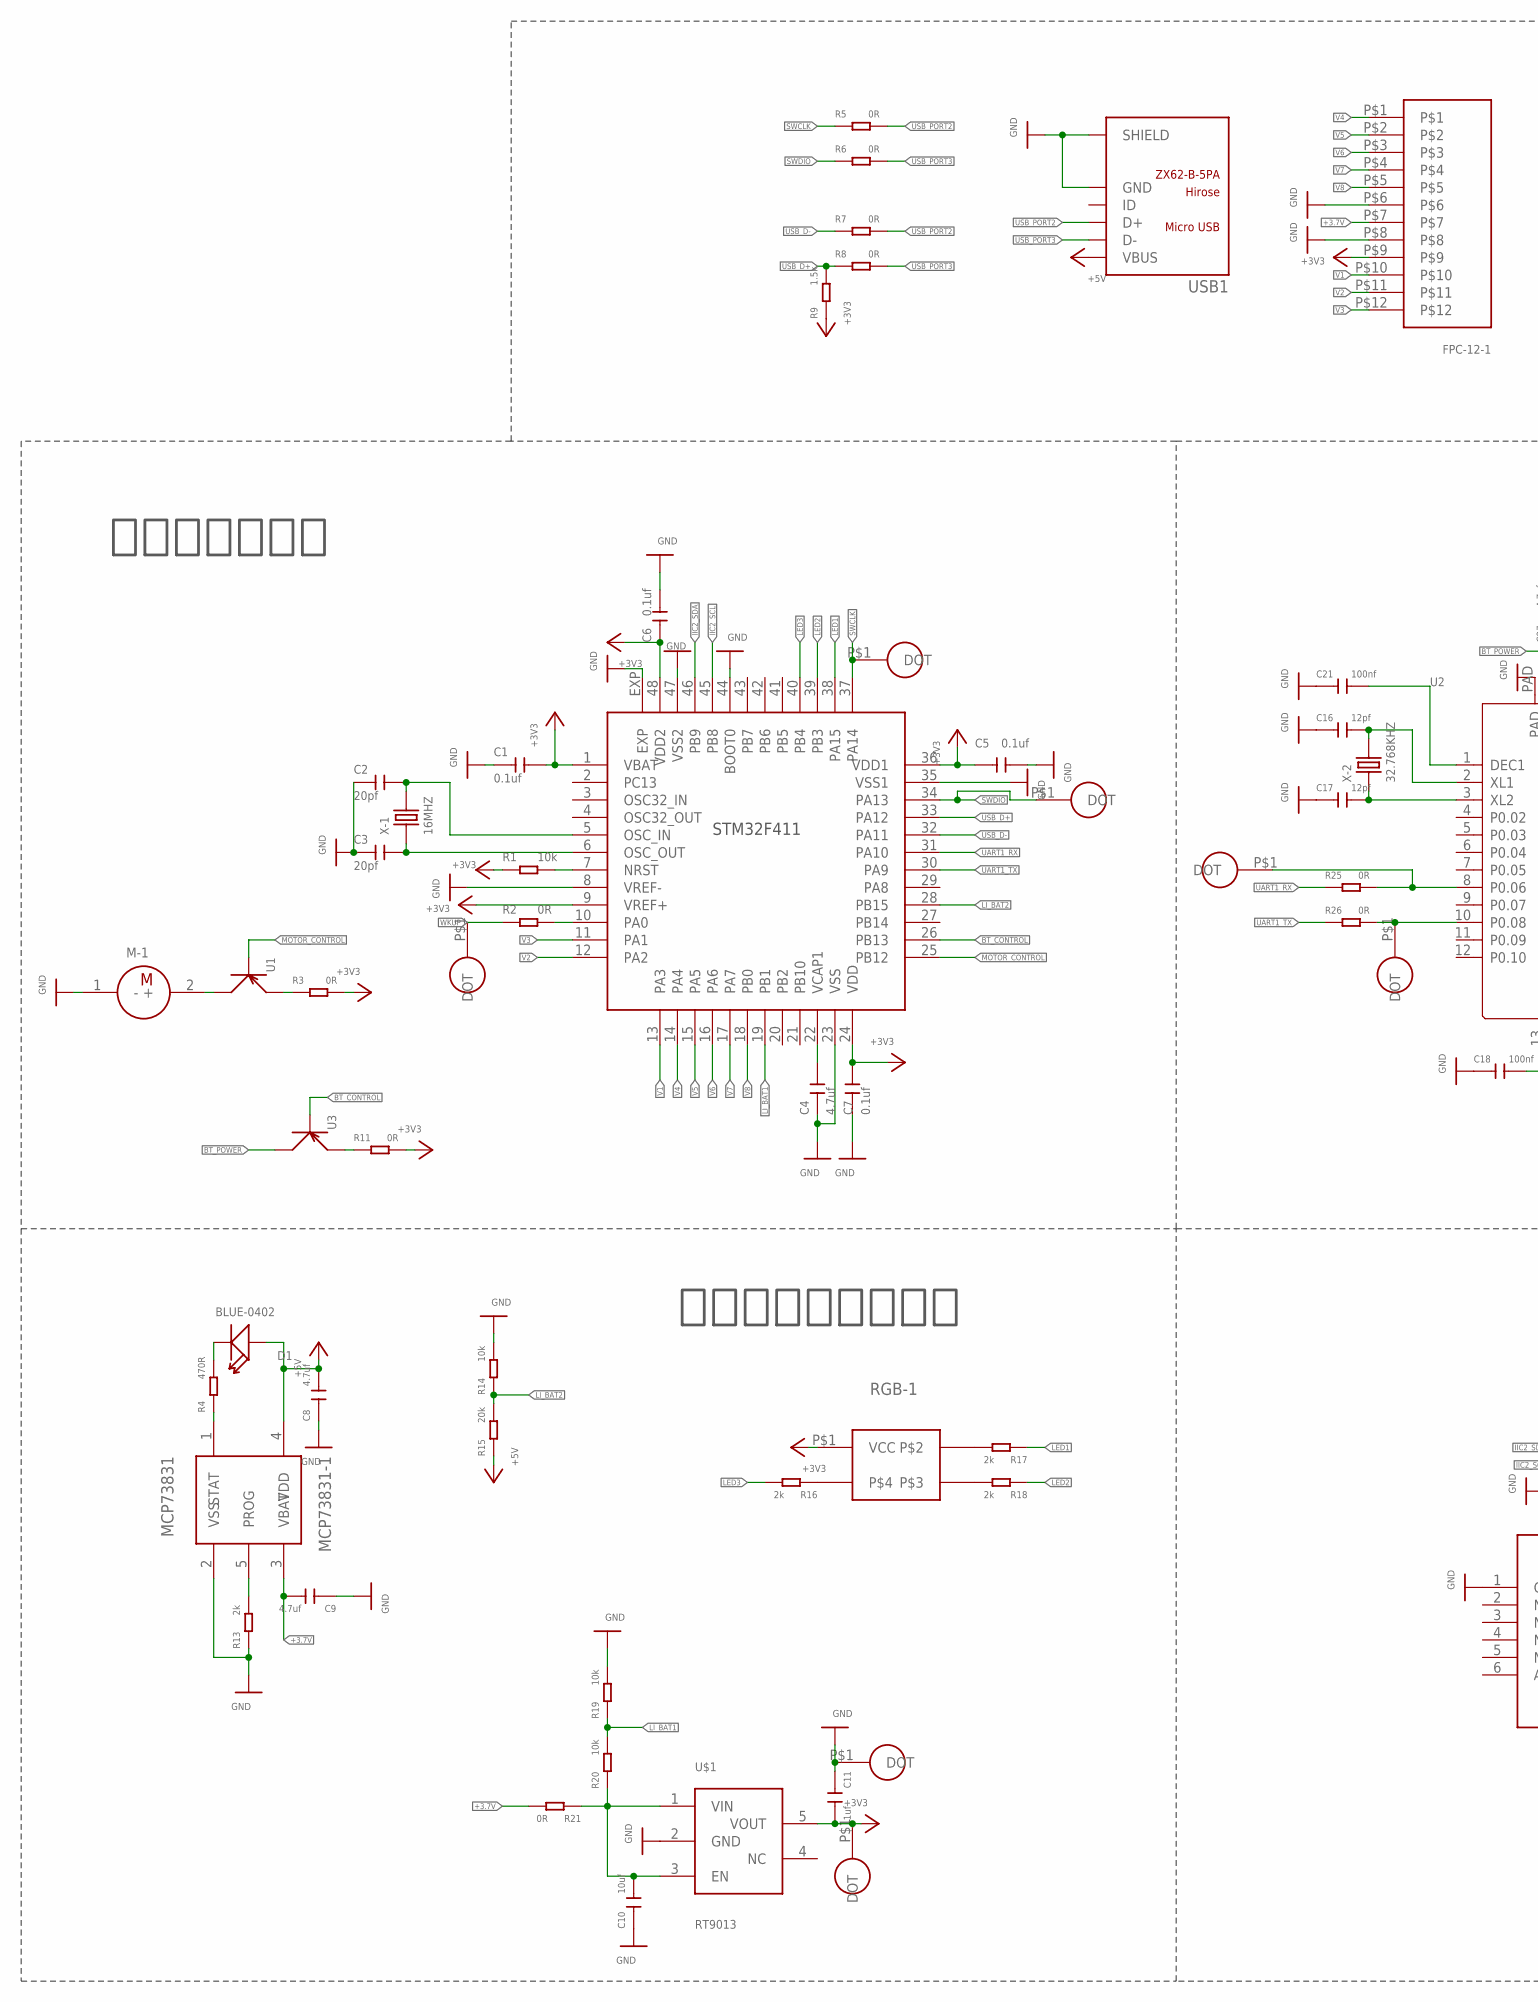
[picture p51: schematic band4.0.sch, part in row 1, column 1]

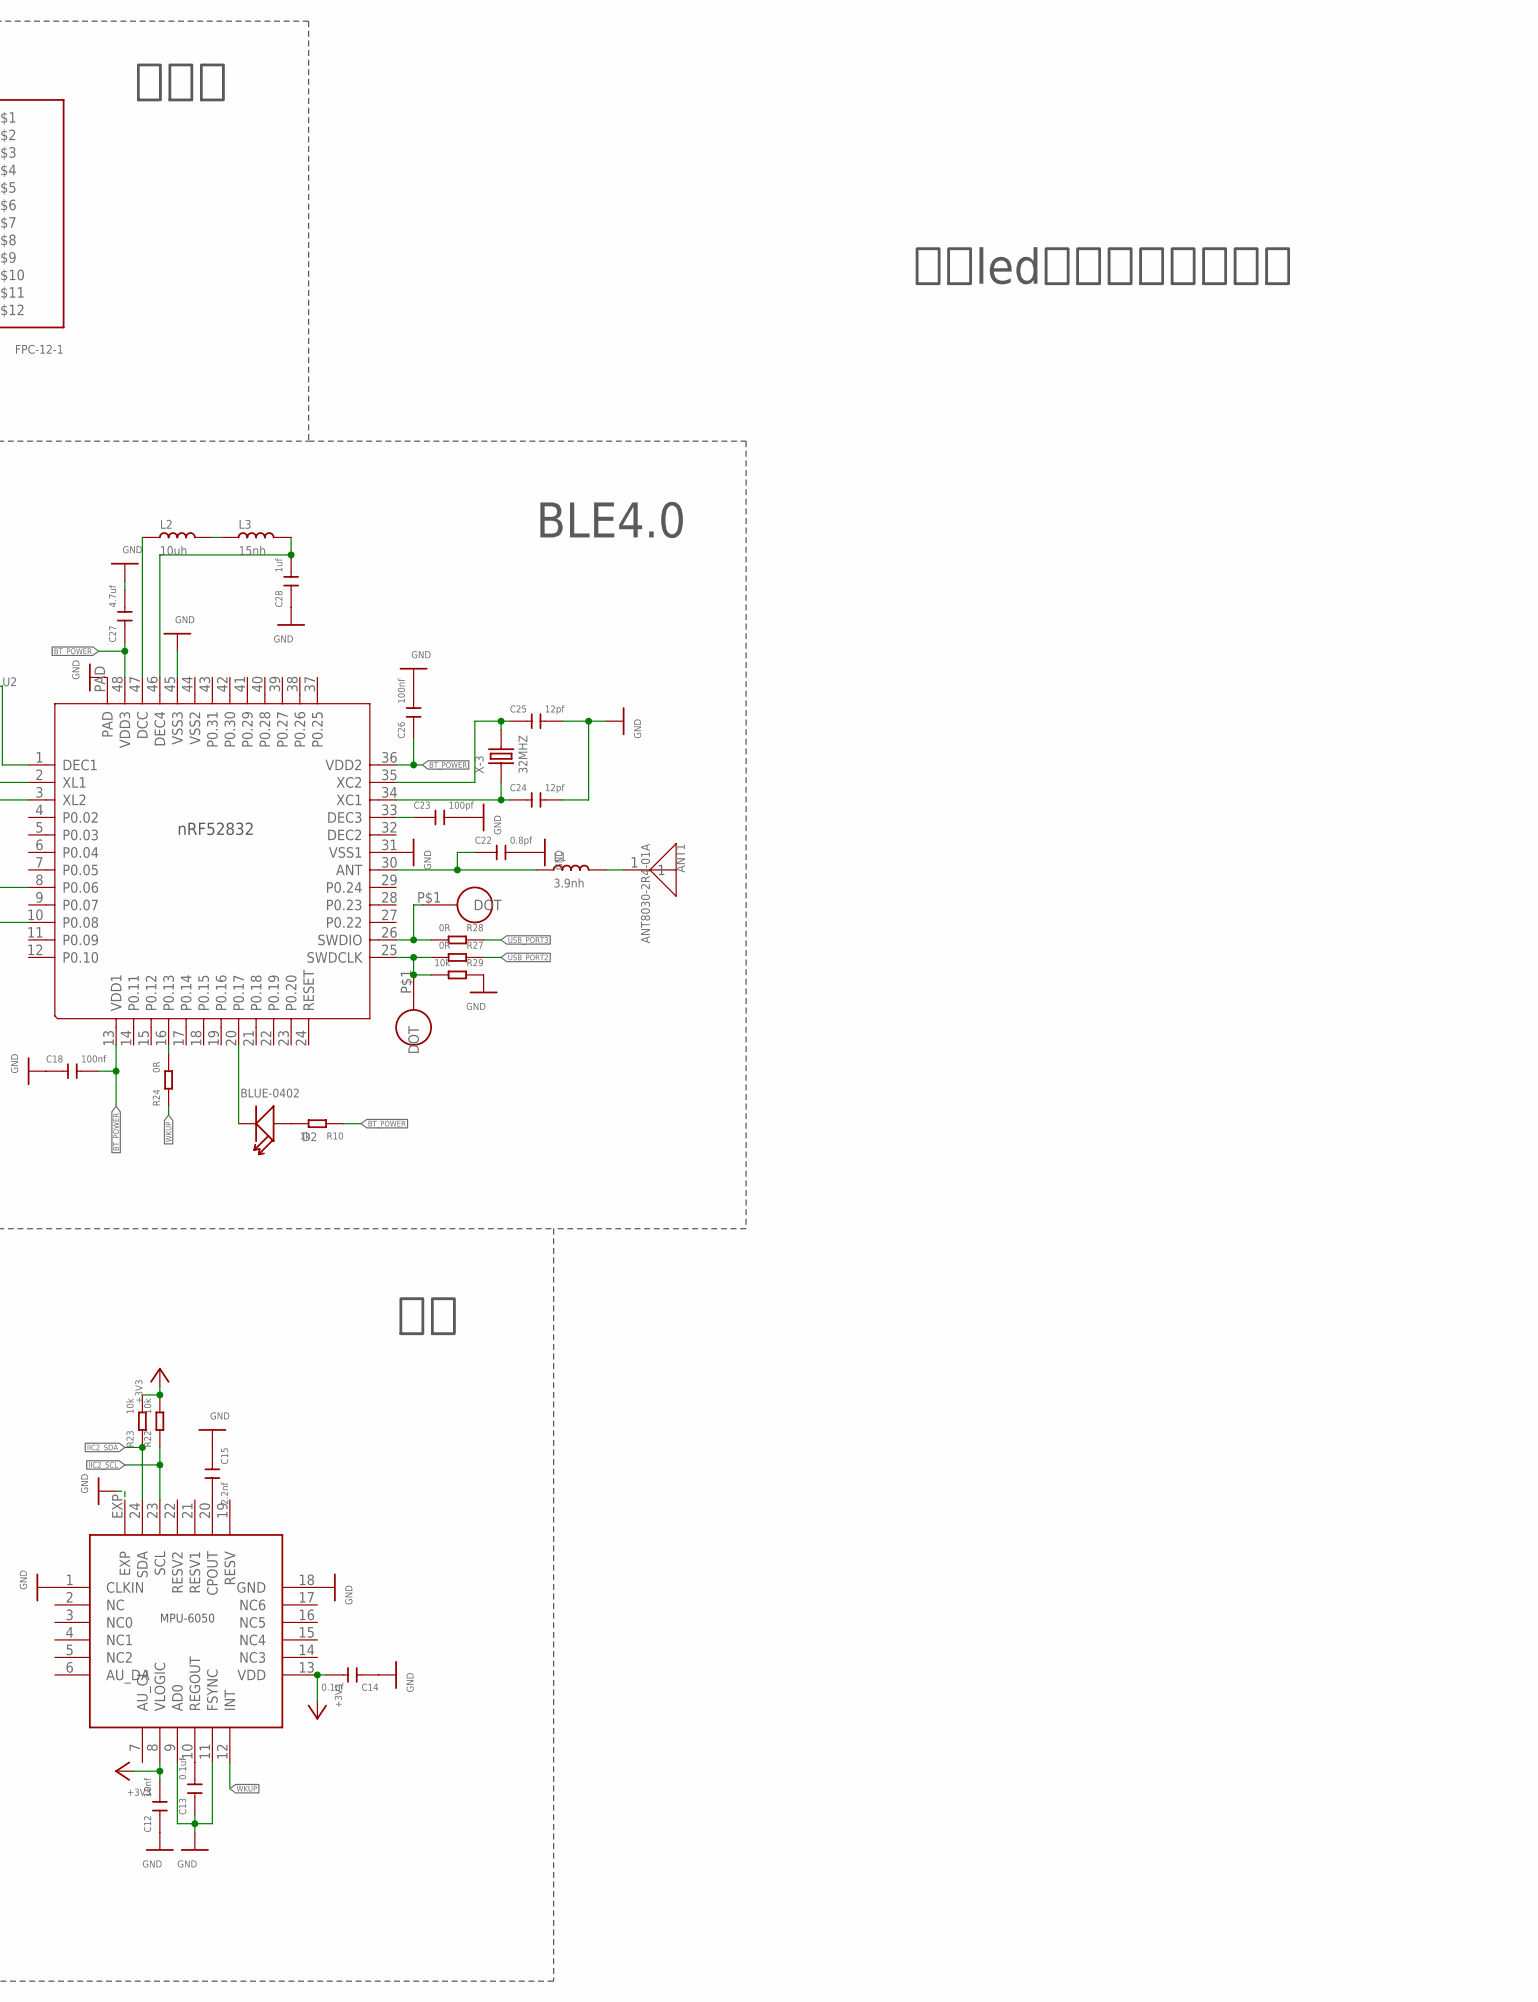
[picture p52: schematic band4.0.sch, part in row 1, column 2]

Parts:
ANT1: ANT8030-2R4-01A; ANTENNA
C1, C5, C6, C7, C13, C14: 0.1uf; C0402
C2, C3: 20pf; C0402
C4, C8, C9, C27: 4.7uf; C0402
C10: 10uf; C0402
C11, C28: 1uf; C0402
C12: 10nf; C0402
C15: 2.2nf; C0402
C16, C17, C24, C25: 12pf; C0402
C18, C21, C26: 100nf; C0402
C22: 0.8pf; C0402
C23: 100pf; C0402
D1, D2: BLUE-0402; LED-0402
FPC-12-1: FPC-12
L1: 3.9nh; L0402
L2: 10uh; L0402
L3: 15nh; L0402
M-1: MOTOR
MCP73831-1: MCP73831; SOT23-5
MPU6050-1: MPU-6050; QFN24-4X4
R1, R14, R19, R20, R22, R23, R29: 10k; R0402
R2, R3, R5, R6, R7, R8, R11, R21, R24, R25, R26, R27, R28: 0R; R0402
R4: 470R; R0402
R9: 1.5k; R0402
R10: 1k; R0402
R13, R16, R17, R18: 2k; R0402
R15: 20k; R0402
RGB-1: RGB-LED
STM32F411-1: STM32F411; QFN48-7X7
U1, U3: PNP
U2: RF-51822; QFN48G-0.4-6X6MM
U$1: RT9013; SC-70-5
U$2, U$3, U$4, U$5, U$6, U$7, U$8, U$9, U$10: TEST-POINT
USB1: ZX62-B-5PA; MICRO-USB5+6P-SMD-0.65-AB
X-1: 16MHZ
X-2: 32.768KHZ
X-3: 32MHZ; 16MHZ

Connections:
+3.7V: C9.2, FPC-12-1.P$7, MCP73831-1.3 (VBAT), R21.2
+3V3: C1.2, C5.1, C6.1, C7.2, C11.2, C12.2, C14.2, FPC-12-1.P$9, MPU6050-1.8 (VLOGIC), MPU6050-1.13 (VDD), R1.1, R3.2, R9.1, R11.2, R22.2, R23.2, RGB-1.P$1 (VCC), STM32F411-1.1 (VBAT), STM32F411-1.9 (VREF+), STM32F411-1.24 (VDD), STM32F411-1.36 (VDD1), STM32F411-1.48 (VDD2), U$1.5 (VOUT), U$5.P$1
+5V: C8.2, D1.+, MCP73831-1.4 (VDD), R15.1, USB1.1 (VBUS)
BT_CONTROL: STM32F411-1.26 (PB13), U3.1 (B)
BT_POWER: C18.2, C26.1, C27.1, R10.1, U2.13 (VDD1), U2.36 (VDD2), U2.48 (VDD3), U3.3 (C)
GND: C1.1, C2.1, C3.1, C4.1, C5.2, C6.2, C7.1, C8.1, C9.1, C10.1, C11.1, C12.1, C13.1, C14.1, C15.1, C16.1, C17.1, C18.1, C21.1, C22.2, C23.2, C24.2, C25.2, C26.2, C27.2, C28.1, FPC-12-1.P$6, FPC-12-1.P$8, M-1.1 (-), MCP73831-1.2 (VSS), MPU6050-1.1 (CLKIN), MPU6050-1.9 (AD0), MPU6050-1.11 (FSYNC), MPU6050-1.18 (GND), MPU6050-1.EXP, R13.1, R14.2, R19.2, R29.1, STM32F411-1.8 (VREF-), STM32F411-1.23 (VSS), STM32F411-1.35 (VSS1), STM32F411-1.44 (BOOT0), STM32F411-1.47 (VSS2), STM32F411-1.EXP, U2.31 (VSS1), U2.45 (VSS3), U2.PAD, U$1.2 (GND), U$6.P$1, USB1.5 (GND), USB1.P1 (SHIELD), USB1.P2 (SHIELD), USB1.P3 (SHIELD), USB1.P4 (SHIELD), USB1.P5 (SHIELD), USB1.P6 (SHIELD)
IIC2_SCL: MPU6050-1.23 (SCL), R22.1, STM32F411-1.45 (PB8)
IIC2_SDA: MPU6050-1.24 (SDA), R23.1, STM32F411-1.46 (PB9)
LED1: R17.1, STM32F411-1.38 (PA15)
LED2: R18.1, STM32F411-1.39 (PB3)
LED3: R16.2, STM32F411-1.40 (PB4)
LI_BAT1: R19.1, R20.2, STM32F411-1.19 (PB1)
LI_BAT2: R14.1, R15.2, STM32F411-1.28 (PB15)
MOTOR_CONTROL: STM32F411-1.25 (PB12), U1.1 (B)
unnamed: C2.2, STM32F411-1.5 (OSC_IN), X-1.3 (2)
unnamed: C3.2, STM32F411-1.6 (OSC_OUT), X-1.1
unnamed: R1.2, STM32F411-1.7 (NRST)
unnamed: R2.2, STM32F411-1.10 (PA0)
unnamed: MCP73831-1.1 (STAT), R4.1
unnamed: D1.-, R4.2
unnamed: MCP73831-1.5 (PROG), R13.2
unnamed: R16.1, RGB-1.P$4
unnamed: R17.2, RGB-1.P$2
unnamed: R18.2, RGB-1.P$3
unnamed: C21.2, U2.1 (DEC1)
unnamed: C13.2, MPU6050-1.10 (REGOUT)
unnamed: C16.2, U2.2 (XL1), X-2.P$2 (2)
unnamed: C10.2, R20.1, R21.1, U$1.1 (VIN), U$1.3 (EN)
unnamed: C15.2, MPU6050-1.20 (CPOUT)
unnamed: C17.2, U2.3 (XL2), X-2.P$1 (1)
unnamed: R25.2, U2.8 (P0.06), U$10.P$1
unnamed: R24.2, U2.16 (P0.13)
unnamed: D2.+, R10.2
unnamed: R26.2, U2.10 (P0.08), U$9.P$1
unnamed: D2.-, U2.20 (P0.17)
unnamed: R11.1, U3.2 (E)
unnamed: R27.2, R29.2, U2.25 (SWDCLK), U$8.P$1
unnamed: R28.2, U2.26 (SWDIO), U$7.P$1
unnamed: ANT1.1, L1.2
unnamed: C4.2, STM32F411-1.22 (VCAP1)
unnamed: M-1.2 (+), U1.3 (C)
unnamed: R3.1, U1.2 (E)
unnamed: C22.1, L1.1, U2.30 (ANT)
unnamed: C23.1, U2.33 (DEC3)
unnamed: C24.1, U2.34 (XC1), X-3.1
unnamed: C25.1, U2.35 (XC2), X-3.3 (2)
unnamed: L2.2, L3.1
unnamed: L2.1, U2.47 (DCC)
unnamed: C28.2, L3.2, U2.46 (DEC4)
SWCLK: R5.1, STM32F411-1.37 (PA14), U$2.P$1
SWDIO: R6.1, STM32F411-1.34 (PA13), U$3.P$1
UART1_RX: R25.1, STM32F411-1.31 (PA10)
UART1_TX: R26.1, STM32F411-1.30 (PA9)
USB_D+: R8.1, R9.2, STM32F411-1.33 (PA12)
USB_D-: R7.1, STM32F411-1.32 (PA11)
USB_PORT2: R5.2, R7.2, R27.1, USB1.3 (D+)
USB_PORT3: R6.2, R8.2, R28.1, USB1.2 (D-)
V1: FPC-12-1.P$10, STM32F411-1.13 (PA3)
V2: FPC-12-1.P$11, STM32F411-1.12 (PA2)
V3: FPC-12-1.P$12, STM32F411-1.11 (PA1)
V4: FPC-12-1.P$1, STM32F411-1.14 (PA4)
V5: FPC-12-1.P$2, STM32F411-1.15 (PA5)
V6: FPC-12-1.P$3, STM32F411-1.16 (PA6)
V7: FPC-12-1.P$4, STM32F411-1.17 (PA7)
V8: FPC-12-1.P$5, STM32F411-1.18 (PB0)
WKUP: MPU6050-1.12 (INT), R2.1, R24.1, U$4.P$1

Notes on the sheet:
主控及震动反馈
电源管理及状态指示
蓝牙led状态指示灯两个？
BLE4.0
连接件

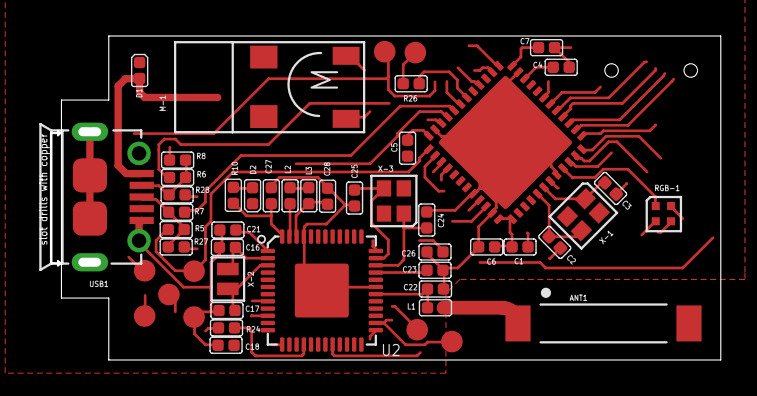
[picture p53: board 旧版本肌电臂环全部内容/肌电臂环资料(朝旭发的)/band4.0-蓝牙的主从/slave/band4.0.brd from above]

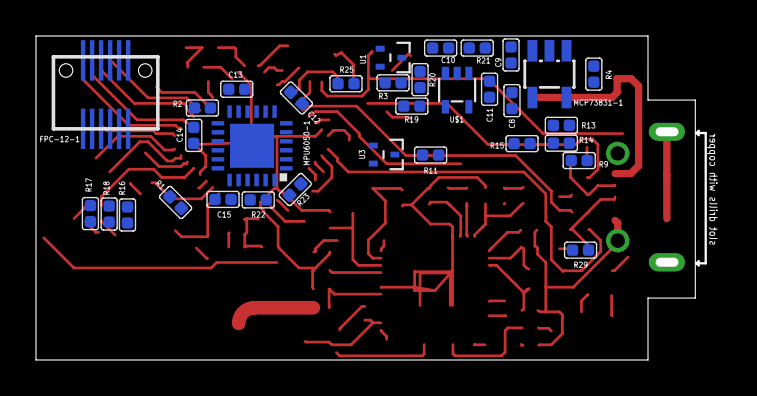
[picture p54: board 旧版本肌电臂环全部内容/肌电臂环资料(朝旭发的)/band4.0-蓝牙的主从/slave/band4.0.brd from below]

Board: 4 copper layers, 37.2 x 18.0 mm, 83 parts (33 on the bottom side), 66 nets.
