woshinamoda/eCon_ArmLet/旧版本肌电臂环全部内容/肌电臂环资料(朝旭发的)/PCB_SingleSupplyEMG-肌电测试模块/ss_emg.brd

## EAGLE design 旧版本肌电臂环全部内容/肌电臂环资料(朝旭发的)/PCB_SingleSupplyEMG-肌电测试模块/ss_emg.brd (2022-08-29, an earlier design)

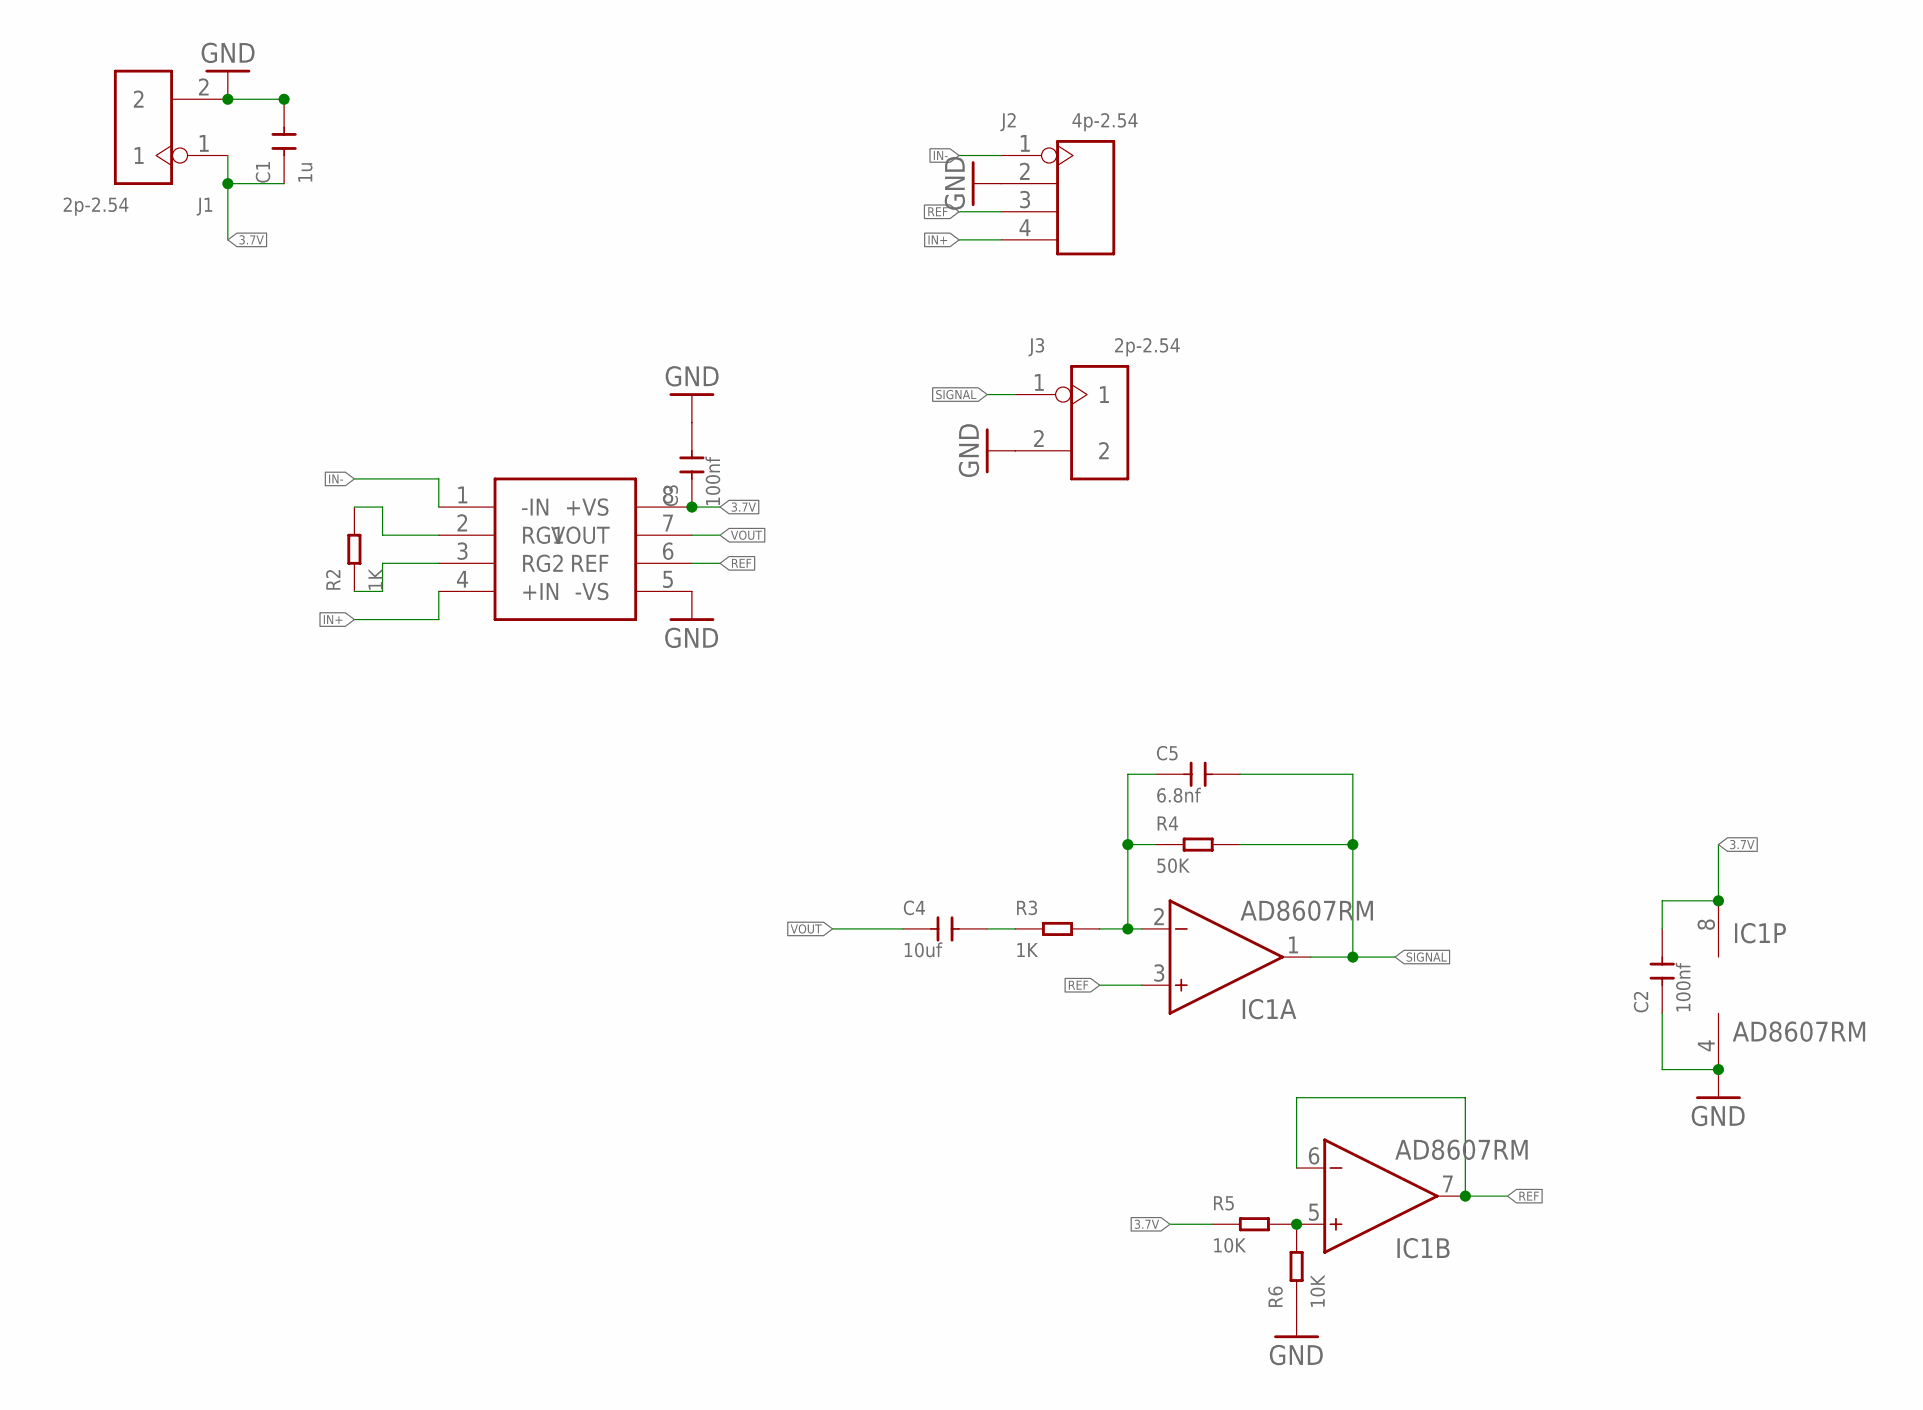
[picture p55: schematic ss_emg.sch]

Parts:
C1: 1u; C0402
C2, C3: 100nf; C0402
C4: 10uf; C0402
C5: 6.8nf; C0402
IC1: AD8607RM; MSOP08
J1, J3: 2p-2.54; H2-2.54
J2: 4p-2.54; H4-2.54
R2, R3: 1K; R0402
R4: 50K; R0402
R5, R6: 10K; R0402
U$1: AD8221; MSOP08

Connections:
3.7V: C1.1, C2.2, C3.1, IC1.8 (V+), J1.1, R5.1, U$1.8 (+VS)
GND: C1.2, C2.1, C3.2, IC1.4 (V-), J1.2, J2.2, J3.2, R6.1, U$1.5 (-VS)
IN+: J2.4, U$1.4 (+IN)
IN-: J2.1, U$1.1 (-IN)
unnamed: R2.2, U$1.2 (RG1)
unnamed: R2.1, U$1.3 (RG2)
unnamed: C4.2, R3.1
unnamed: C5.1, IC1.2 (IN-), R3.2, R4.1
unnamed: IC1.5 (IN+), R5.2, R6.2
REF: IC1.3 (IN+), IC1.6 (IN-), IC1.7 (OUT), J2.3, U$1.6 (REF)
SIGNAL: C5.2, IC1.1 (OUT), J3.1, R4.2
VOUT: C4.1, U$1.7 (VOUT)

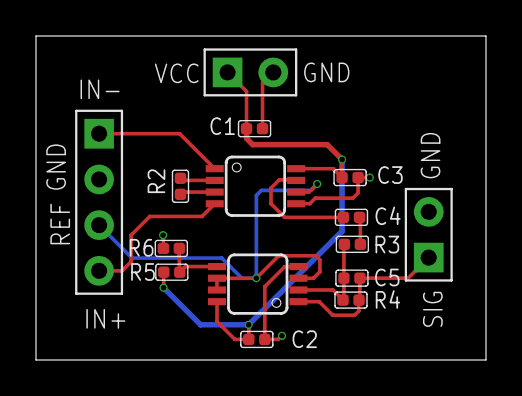
[picture p56: board ss_emg.brd from above]

Board: 2 copper layers, 25.0 x 18.0 mm, 15 parts (0 on the bottom side), 12 nets.
