woshinamoda/eCon_ArmLet/旧版本肌电臂环全部内容/肌电臂环资料(朝旭发的)/band4.0-蓝牙的主从/host/host.brd

## EAGLE design 旧版本肌电臂环全部内容/肌电臂环资料(朝旭发的)/band4.0-蓝牙的主从/host/host.brd (2022-08-29, an earlier design)

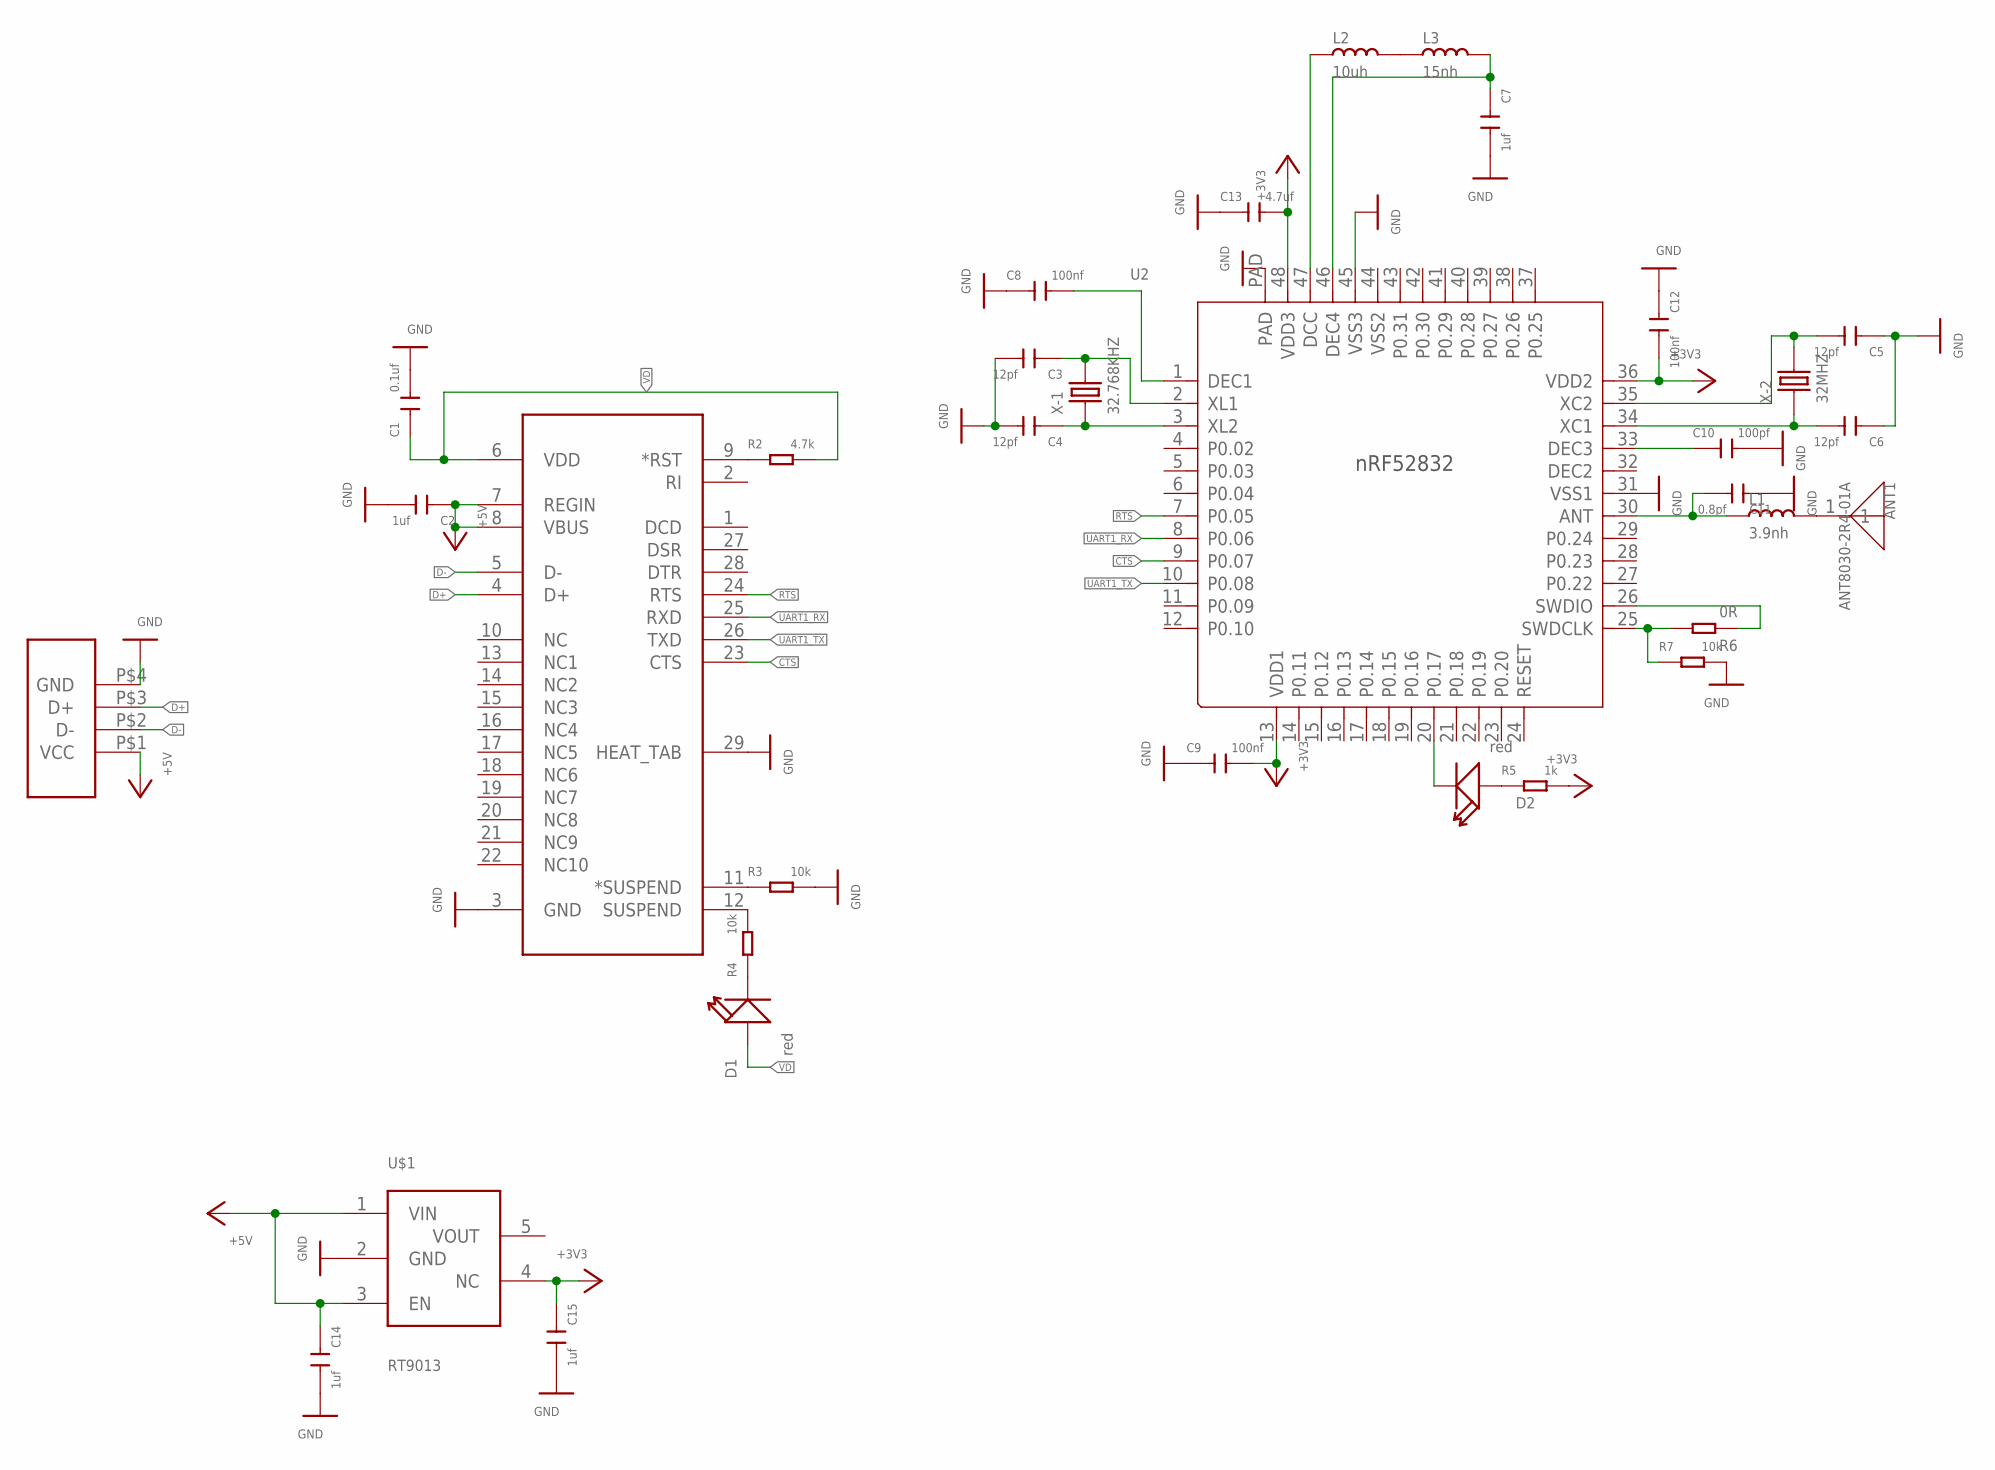
[picture p57: schematic host.sch]

Parts:
ANT1: ANT8030-2R4-01A; ANTENNA
C1: 0.1uf; C0402
C2, C7, C14, C15: 1uf; C0402
C3, C4, C5, C6: 12pf; C0402
C8, C9, C12: 100nf; C0402
C10: 100pf; C0402
C11: 0.8pf; C0402
C13: 4.7uf; C0402
CP1: CP2102; QFN28G_0.5-5X5MM
D1, D2: red; LED-0402
L1: 3.9nh; L0402
L2: 10uh; L0402
L3: 15nh; L0402
R2: 4.7k; R0402
R3, R4, R7: 10k; R0402
R5: 1k; R0402
R6: 0R; R0603
U1: USB-4PIN; USB-HW-4PIN
U2: RF-51822; QFN48G-0.4-6X6MM
U$1: RT9013; SC-70-5
X-1: 32.768KHZ
X-2: 32MHZ; 16MHZ

Connections:
+3V3: C9.2, C12.2, C13.2, C15.1, R5.2, U2.13 (VDD1), U2.36 (VDD2), U2.48 (VDD3), U$1.4 (NC)
+5V: C2.1, C14.1, CP1.7 (REGIN), CP1.8 (VBUS), U1.P$1 (VCC), U$1.1 (VIN), U$1.3 (EN)
CTS: CP1.23 (CTS), U2.9 (P0.07)
D+: CP1.4 (D+), U1.P$3 (D+)
D-: CP1.5 (D-), U1.P$2 (D-)
GND: C1.2, C2.2, C3.2, C4.2, C5.1, C6.1, C7.2, C8.1, C9.1, C10.2, C11.1, C12.1, C13.1, C14.2, C15.2, CP1.3 (GND), CP1.29 (HEAT_TAB), R3.2, R7.2, U1.P$4 (GND), U2.31 (VSS1), U2.45 (VSS3), U2.PAD, U$1.2 (GND)
unnamed: CP1.9 (*RST), R2.1
unnamed: CP1.11 (*SUSPEND), R3.1
unnamed: CP1.12 (SUSPEND), R4.2
unnamed: C8.2, U2.1 (DEC1)
unnamed: D1.-, R4.1
unnamed: C3.1, U2.2 (XL1), X-1.P$2 (2)
unnamed: C4.1, U2.3 (XL2), X-1.P$1 (1)
unnamed: D2.+, R5.1
unnamed: D2.-, U2.20 (P0.17)
unnamed: R6.2, R7.1, U2.25 (SWDCLK)
unnamed: R6.1, U2.26 (SWDIO)
unnamed: ANT1.1, L1.2
unnamed: C11.2, L1.1, U2.30 (ANT)
unnamed: C10.1, U2.33 (DEC3)
unnamed: C6.2, U2.34 (XC1), X-2.1
unnamed: C5.2, U2.35 (XC2), X-2.3 (2)
unnamed: L2.2, L3.1
unnamed: L2.1, U2.47 (DCC)
unnamed: C7.1, L3.2, U2.46 (DEC4)
RTS: CP1.24 (RTS), U2.7 (P0.05)
UART1_RX: CP1.25 (RXD), U2.8 (P0.06)
UART1_TX: CP1.26 (TXD), U2.10 (P0.08)
VD: C1.1, CP1.6 (VDD), D1.+, R2.2

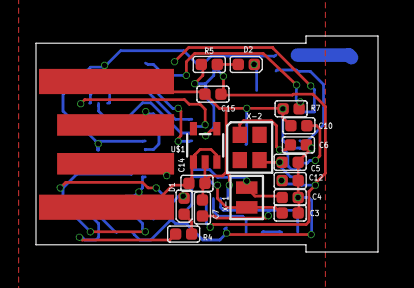
[picture p58: board host.brd from above]

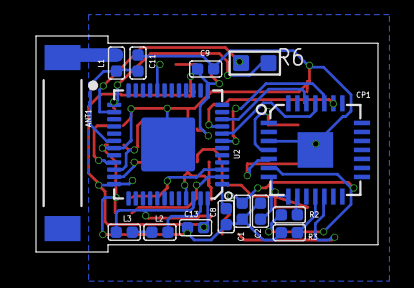
[picture p59: board host.brd from below]

Board: 2 copper layers, 19.0 x 12.0 mm, 33 parts (15 on the bottom side), 29 nets.
