woshinamoda/eCon_ArmLet/旧版本肌电臂环全部内容/肌电臂环资料(朝旭发的)/Newarm/HandBand_HW/HW1.0/band4.0.brd

## EAGLE design 旧版本肌电臂环全部内容/肌电臂环资料(朝旭发的)/Newarm/HandBand_HW/HW1.0/band4.0.brd (2022-08-29, an earlier design)

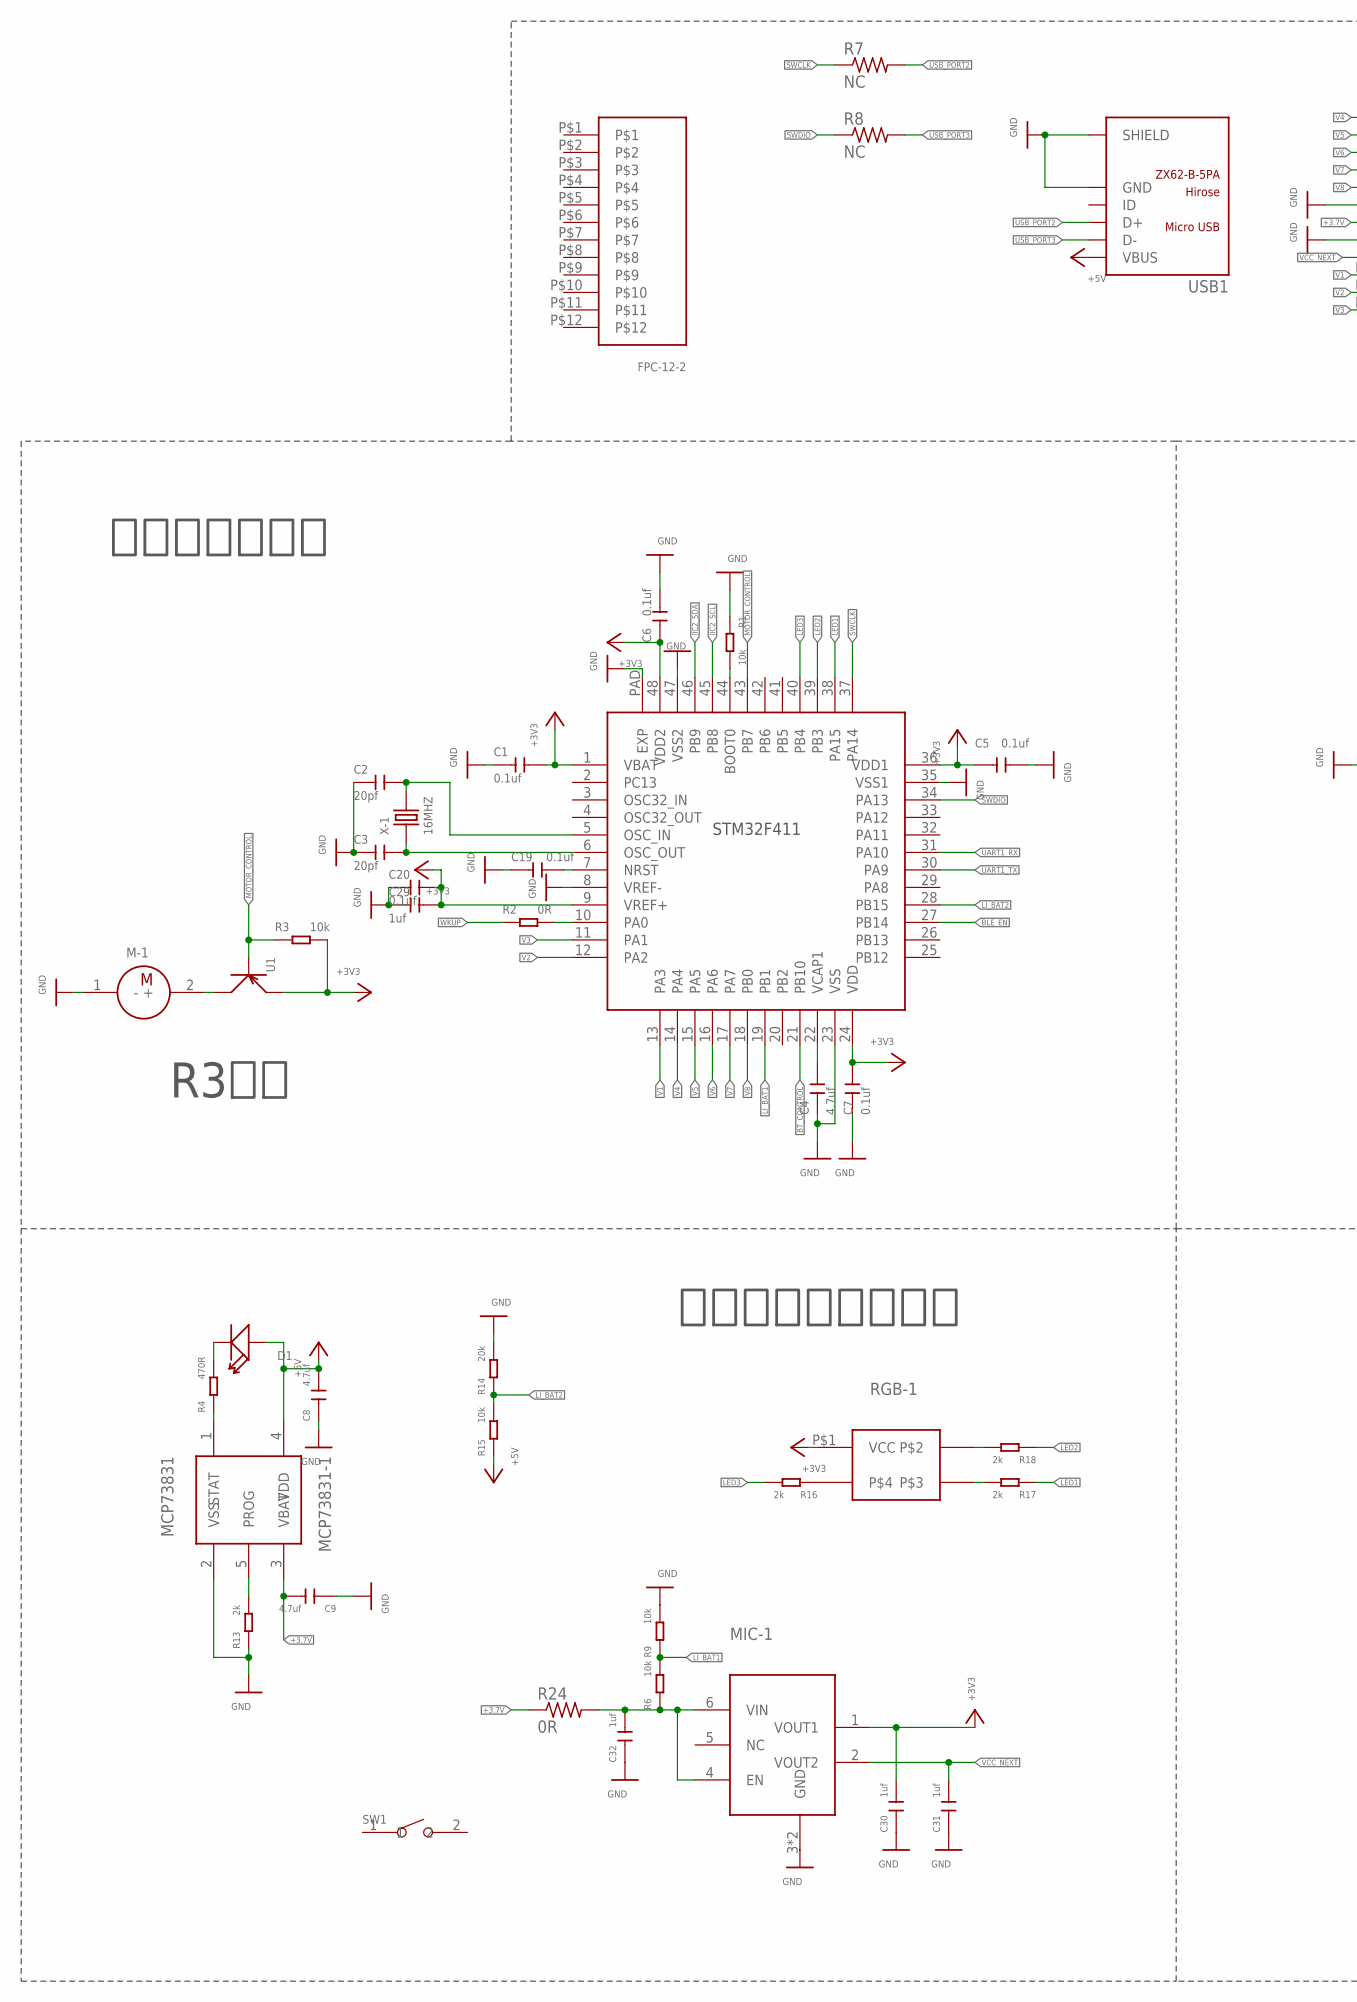
[picture p60: schematic band4.0.sch, part in row 1, column 1]

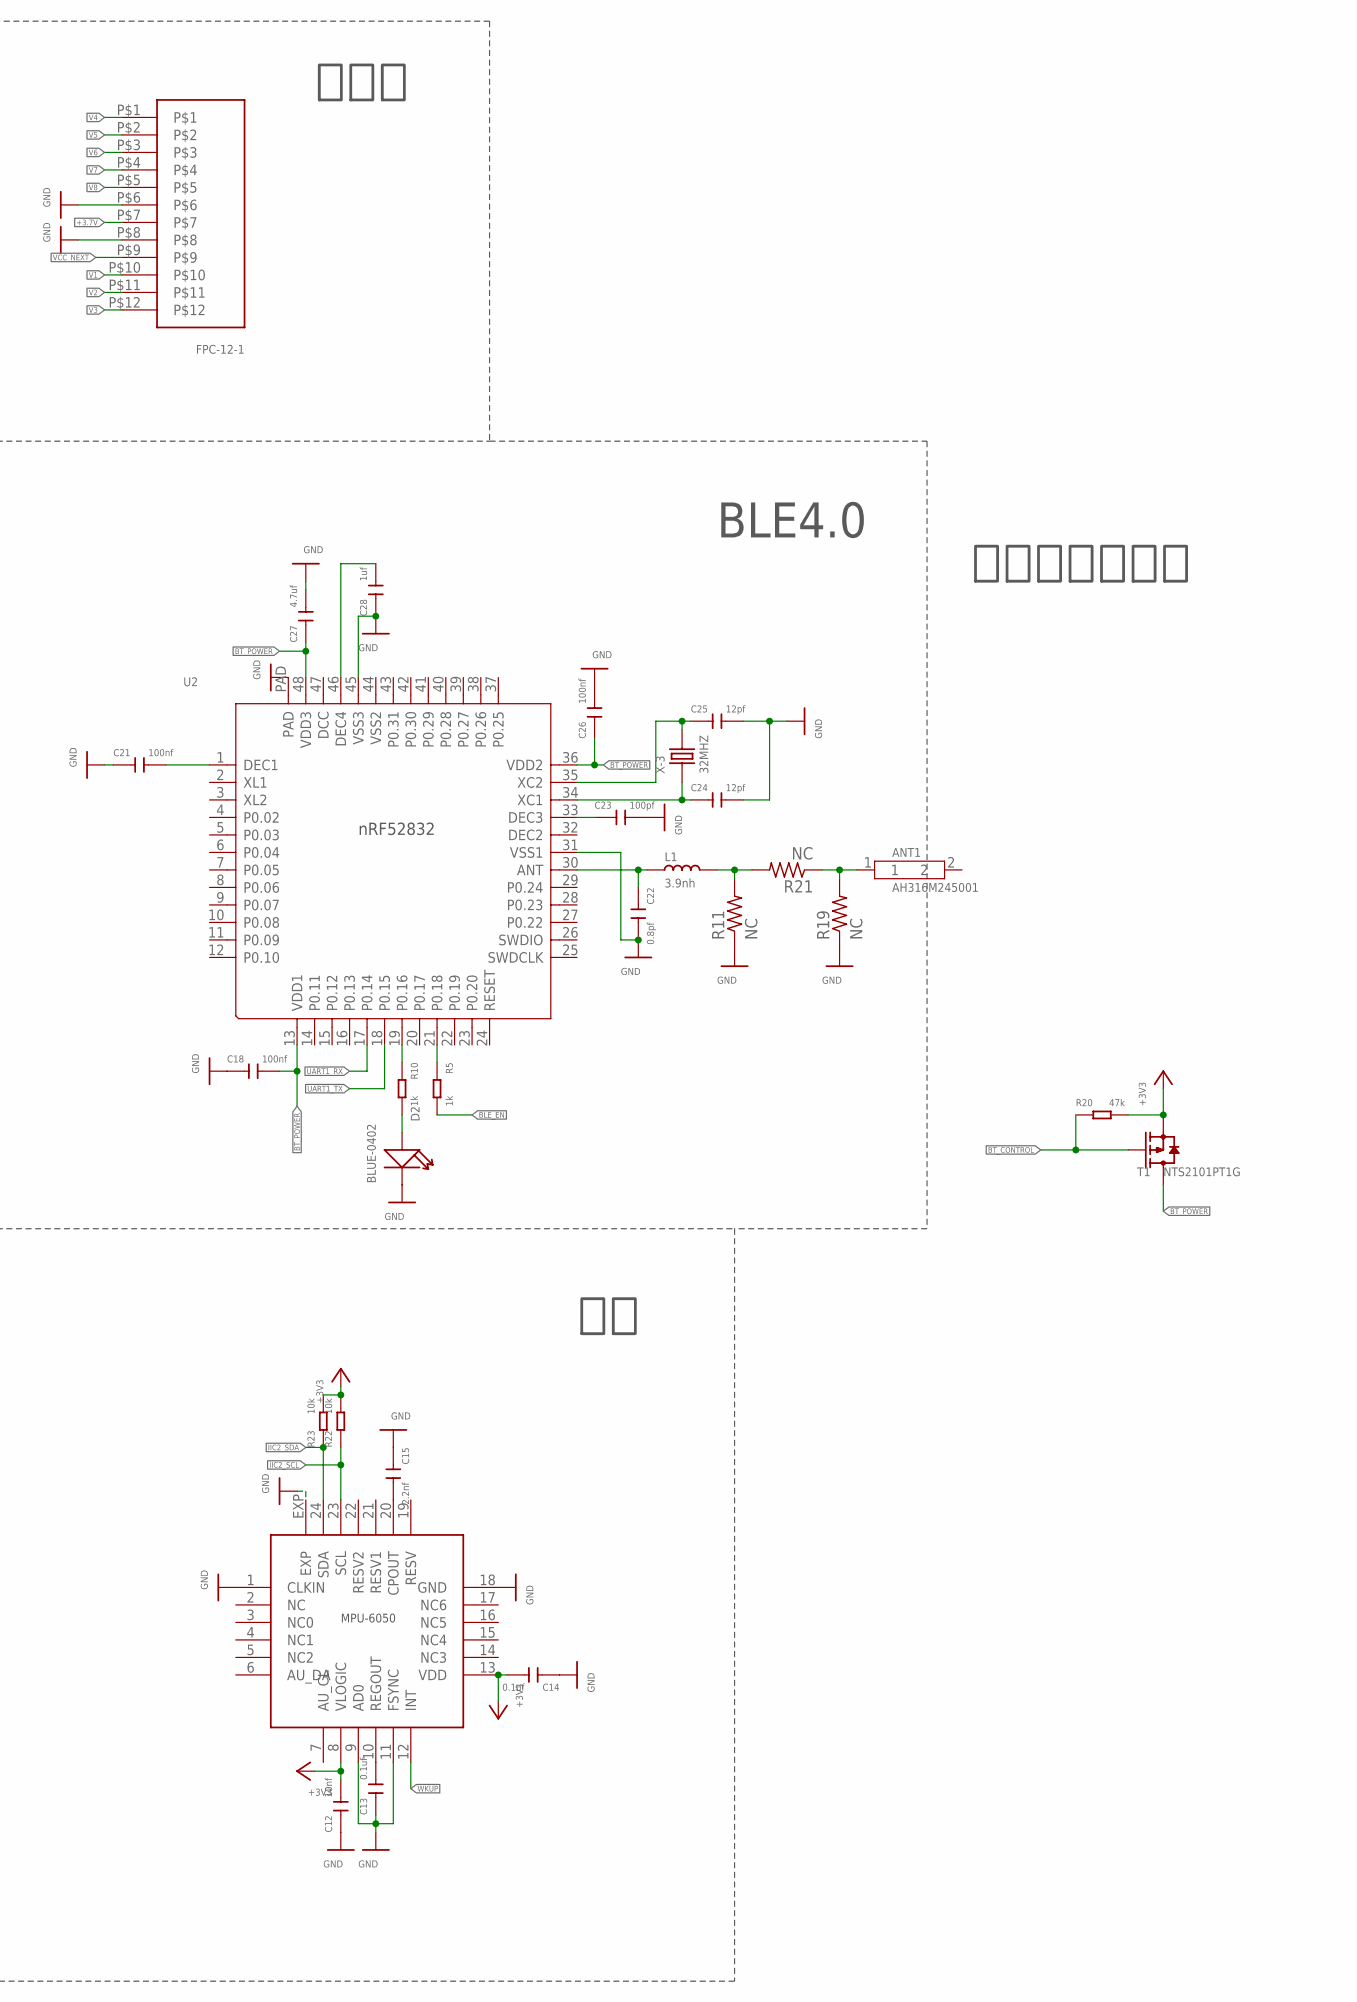
[picture p61: schematic band4.0.sch, part in row 1, column 2]

Parts:
ANT1: AH316M245001; ANT2-SMD-3.2X1.6X0.5MM
C1, C5, C6, C7, C13, C14, C19, C20: 0.1uf; C0402
C2, C3: 20pf; C0402
C4, C8, C9, C27: 4.7uf; C0402
C12: 10nf; C0402
C15: 2.2nf; C0402
C18, C21, C26: 100nf; C0402
C22: 0.8pf; C0402
C23: 100pf; C0402
C24, C25: 12pf; C0402
C28, C29, C30, C31, C32: 1uf; C0402
D1: LED-(0402); LED-0402
D2: BLUE-0402; LED-0402
FPC-12-1, FPC-12-2: FPC-12
L1: 3.9nh; L0402
M-1: MOTOR
MCP73831-1: MCP73831; SOT23-5
MCU-1: STM32F411; QFN48G-0.5-7X7MM
MIC-1: MIC5528; THIN-DFN
MPU6050-1: MPU-6050; QFN24-4X4
R1, R3, R6, R9, R15, R22, R23: 10k; R0402
R2: 0R; R0402
R4: 470R; R0402
R5, R10: 1k; R0402
R7, R8, R11, R19, R21: NC; 0201
R13, R16, R17, R18: 2k; R0402
R14: 20k; R0402
R20: 47k; R0402
R24: 0R; 0201
RGB-1: RGB-LED
SW1: SMD-BUTTON(2P-6.0X3.0X2.5MM)-DHT-1163S; SW2-4.0-6.0X3.0X2.5MM
T1: NTS2101PT1G; SC70
U1: PNP
U2: RF-51822; QFN48G-0.4-6X6MM
USB1: ZX62-B-5PA; MICRO-USB5+6P-SMD-0.65-AB
X-1: 16MHZ
X-3: 32MHZ; 16MHZ

Connections:
+3.7V: C9.2, FPC-12-1.P$7, MCP73831-1.3 (VBAT), R24.1
+3V3: C1.2, C5.1, C6.1, C7.2, C12.2, C14.2, C20.2, C29.2, C30.2, MCU-1.1 (VBAT), MCU-1.9 (VREF+), MCU-1.24 (VDD), MCU-1.36 (VDD1), MCU-1.48 (VDD2), MIC-1.1 (VOUT1), MPU6050-1.8 (VLOGIC), MPU6050-1.13 (VDD), R3.2, R20.2, R22.2, R23.2, RGB-1.P$1 (VCC), T1.2 (S), U1.2 (E)
+5V: C8.2, D1.+, MCP73831-1.4 (VDD), R15.1, USB1.1 (VBUS)
BLE_EN: MCU-1.27 (PB14), R5.2
BT_CONTROL: MCU-1.21 (PB10), R20.1, T1.1 (G)
BT_POWER: C18.2, C26.1, C27.1, T1.3 (D), U2.13 (VDD1), U2.36 (VDD2), U2.48 (VDD3)
GND: C1.1, C2.1, C3.1, C4.1, C5.2, C6.2, C7.1, C8.1, C9.1, C12.1, C13.1, C14.1, C15.1, C18.1, C19.1, C20.1, C21.1, C22.2, C23.2, C24.2, C25.2, C26.2, C27.2, C28.1, C29.1, C30.1, C31.1, C32.1, D2.-, FPC-12-1.P$6, FPC-12-1.P$8, M-1.1 (-), MCP73831-1.2 (VSS), MCU-1.8 (VREF-), MCU-1.23 (VSS), MCU-1.35 (VSS1), MCU-1.47 (VSS2), MCU-1.PAD (EXP), MIC-1.3 (GND), MIC-1.7 (GND), MPU6050-1.1 (CLKIN), MPU6050-1.9 (AD0), MPU6050-1.11 (FSYNC), MPU6050-1.18 (GND), MPU6050-1.EXP, R1.1, R9.2, R11.1, R13.1, R14.2, R19.1, U2.31 (VSS1), U2.45 (VSS3), U2.PAD, USB1.5 (GND), USB1.P1 (SHIELD), USB1.P2 (SHIELD), USB1.P3 (SHIELD), USB1.P4 (SHIELD), USB1.P5 (SHIELD), USB1.P6 (SHIELD)
IIC2_SCL: MCU-1.45 (PB8), MPU6050-1.23 (SCL), R22.1
IIC2_SDA: MCU-1.46 (PB9), MPU6050-1.24 (SDA), R23.1
LED1: MCU-1.38 (PA15), R17.1
LED2: MCU-1.39 (PB3), R18.1
LED3: MCU-1.40 (PB4), R16.2
LI_BAT1: MCU-1.19 (PB1), R6.2, R9.1
LI_BAT2: MCU-1.28 (PB15), R14.1, R15.2
MOTOR_CONTROL: MCU-1.43 (PB7), R3.1, U1.1 (B)
unnamed: C2.2, MCU-1.5 (OSC_IN), X-1.3 (2)
unnamed: C3.2, MCU-1.6 (OSC_OUT), X-1.1
unnamed: C19.2, MCU-1.7 (NRST)
unnamed: MCU-1.10 (PA0), R2.2
unnamed: MCP73831-1.1 (STAT), R4.1
unnamed: D1.-, R4.2
unnamed: MCP73831-1.5 (PROG), R13.2
unnamed: R16.1, RGB-1.P$4
unnamed: R17.2, RGB-1.P$3
unnamed: R18.2, RGB-1.P$2
unnamed: C21.2, U2.1 (DEC1)
unnamed: C13.2, MPU6050-1.10 (REGOUT)
unnamed: R10.1, U2.19 (P0.16)
unnamed: L1.2, R11.2, R21.2
unnamed: C15.2, MPU6050-1.20 (CPOUT)
unnamed: ANT1.1, R19.2, R21.1
unnamed: D2.+, R10.2
unnamed: R5.1, U2.21 (P0.18)
unnamed: MCU-1.44 (BOOT0), R1.2
unnamed: C28.2, U2.46 (DEC4)
unnamed: C32.2, MIC-1.4 (EN), MIC-1.6 (VIN), R6.1, R24.2
unnamed: C4.2, MCU-1.22 (VCAP1)
unnamed: M-1.2 (+), U1.3 (C)
unnamed: C22.1, L1.1, U2.30 (ANT)
unnamed: C23.1, U2.33 (DEC3)
unnamed: C24.1, U2.34 (XC1), X-3.1
unnamed: C25.1, U2.35 (XC2), X-3.3 (2)
SWCLK: MCU-1.37 (PA14), R7.1
SWDIO: MCU-1.34 (PA13), R8.1
UART1_RX: MCU-1.31 (PA10), U2.17 (P0.14)
UART1_TX: MCU-1.30 (PA9), U2.18 (P0.15)
USB_PORT2: R7.2, USB1.3 (D+)
USB_PORT3: R8.2, USB1.2 (D-)
V1: FPC-12-1.P$10, MCU-1.13 (PA3)
V2: FPC-12-1.P$11, MCU-1.12 (PA2)
V3: FPC-12-1.P$12, MCU-1.11 (PA1)
V4: FPC-12-1.P$1, MCU-1.14 (PA4)
V5: FPC-12-1.P$2, MCU-1.15 (PA5)
V6: FPC-12-1.P$3, MCU-1.16 (PA6)
V7: FPC-12-1.P$4, MCU-1.17 (PA7)
V8: FPC-12-1.P$5, MCU-1.18 (PB0)
VCC_NEXT: C31.2, FPC-12-1.P$9, MIC-1.2 (VOUT2)
WKUP: MPU6050-1.12 (INT), R2.1

Notes on the sheet:
主控及震动反馈
电源管理及状态指示
蓝牙的电源控制
BLE4.0
连接件
R3大小

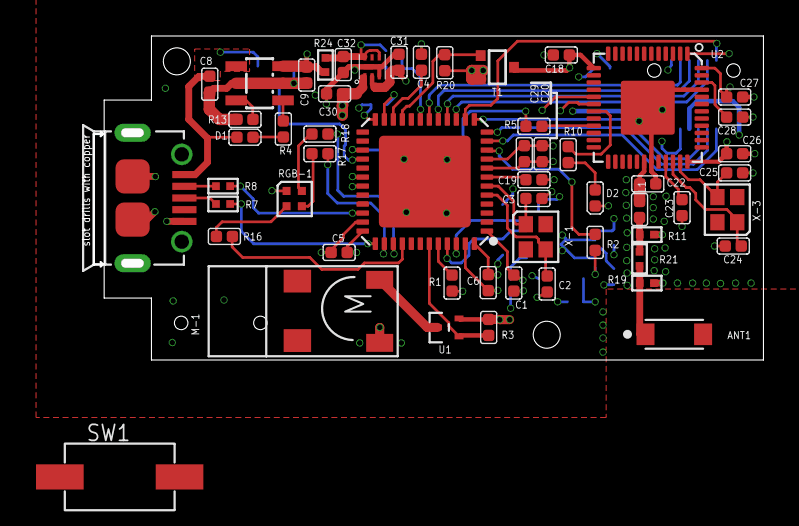
[picture p62: board 旧版本肌电臂环全部内容/肌电臂环资料(朝旭发的)/Newarm/HandBand_HW/HW1.0/band4.0.brd from above]

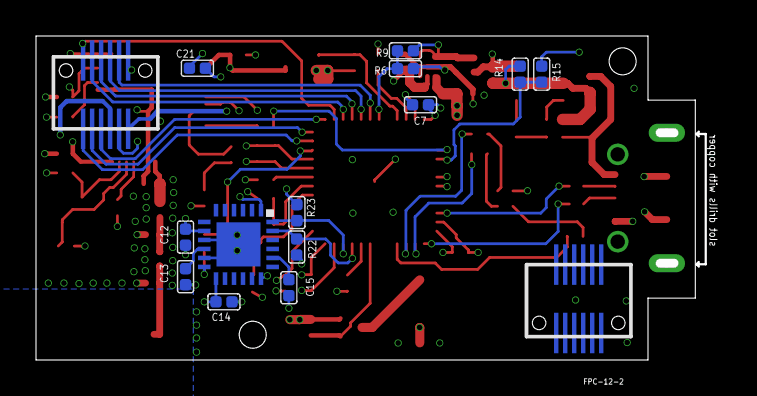
[picture p63: board 旧版本肌电臂环全部内容/肌电臂环资料(朝旭发的)/Newarm/HandBand_HW/HW1.0/band4.0.brd from below]

Board: 4 copper layers, 37.2 x 18.0 mm, 70 parts (15 on the bottom side), 58 nets.
