woshinamoda/eCon_ArmLet/旧版本肌电臂环全部内容/ARMletV1.0.0/Core/Src/main.c

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
/* Includes ------------------------------------------------------------------*/
#include "main.h"
#include "adc.h"
#include "dma.h"
#include "i2c.h"
#include "tim.h"
#include "usart.h"
#include "gpio.h"

/* USER CODE BEGIN Includes */
#include <stdio.h>
#include <stdbool.h>
/* USER CODE END Includes */


/* USER CODE BEGIN PV */
uint32_t AD_Value[20];	/* 8->EMG;1->battery*/
//==============================System work PV==================================
uint8_t work_state;				//工作状态变量	1：充电充满  2：正在充电	3：正常工作	  4：电量不足  5：电量微弱请及时充电
uint8_t Booth_state;			//蓝牙连接状态  0：未连接   1：连接状态
uint8_t Charge_state;			//充电状态		0：正在充   1：已经充满
uint8_t htim9_flag;				//定时器9旗标
uint8_t htim10_flag;			//定时器10旗标
uint8_t TimeFlag;				//EMG中断旗标
uint8_t IMUFlag;				//IMU中断旗标
uint8_t SystemFlag=0;			//完成初始化旗标

//================================IMU 数据测试函数====================================
short gyro[3], accel[3], sensors;
float Pitch,Roll,Yaw;
float q0,q1,q2,q3;
uint8_t OutPut_Buffer[11];
uint8_t	number;

//===============串口1中断接受变量，4个字节用来判断华总发出的指令 ====================
uint8_t	uart_flag;
uint8_t RxBuffer[4];
uint8_t	IMU_state=0;				//是否开启IMU读取				0：关闭		1：开启
uint8_t	Motor_work_time;		//是否开启电机震动			0：关闭		else：开启*100ms的震动

/*用于调试串口*/
//uint8_t	Uart_460800code[16] = {0x41 ,0x54 ,0x2B ,0x42 ,0x41 ,0x55 ,0x44 ,0x3D ,0x34 ,0x36 ,0x30 ,0x38 ,0x30 ,0x30 ,0x0D ,0x0A};		//修改串口波特率460800
//uint8_t	conn_Master_3[25]={0x41 ,0x54 ,0x2B ,0x53 ,0x50 ,0x50 ,0x43 ,0x4F ,0x4E ,0x4E ,0x3D ,0x44 ,0x43 ,0x30 ,0x44 ,0x33 ,0x30 ,0x30 ,0x30 ,0x31 ,0x39 ,0x32 ,0x43 ,0x0D ,0x0A};
////AT+SPPCONN=DC0D3000192C, 3号臂环的自动重连
//uint8_t	conn_Master_11[25]={0x41 ,0x54 ,0x2B ,0x53 ,0x50 ,0x50 ,0x43 ,0x4F ,0x4E ,0x4E ,0x3D ,0x44 ,0x43 ,0x30 ,0x44 ,0x33 ,0x30 ,0x30 ,0x30 ,0x31 ,0x39 ,0x33 ,0x36 ,0x0D ,0x0A};	
////AT+SPPCONN=DC0D30001936, 11号臂环的自动重连	
//uint8_t	conn_Master_18[25]={0x41 ,0x54 ,0x2B ,0x53 ,0x50 ,0x50 ,0x43 ,0x4F ,0x4E ,0x4E ,0x3D ,0x44 ,0x43 ,0x30 ,0x44 ,0x33 ,0x30 ,0x30 ,0x30 ,0x31 ,0x39 ,0x33 ,0x31 ,0x0D ,0x0A};
//AT+SPPCONN=DC0D30001931, 18号臂环的自动重连
//uint8_t	conn_Master_9[25]={0x41 ,0x54 ,0x2B ,0x53 ,0x50 ,0x50 ,0x43 ,0x4F ,0x4E ,0x4E ,0x3D ,0x44 ,0x43 ,0x30 ,0x44 ,0x33 ,0x30 ,0x30 ,0x30 ,0x31 ,0x39 ,0x33 ,0x43 ,0x0D ,0x0A};	
//AT+SPPCONN=DC0D3000193C，9号臂环的自动重连
//uint8_t	conn_Master_15[25]={0x41 ,0x54 ,0x2B ,0x53 ,0x50 ,0x50 ,0x43 ,0x4F ,0x4E ,0x4E ,0x3D ,0x44 ,0x43 ,0x30 ,0x44 ,0x33 ,0x30 ,0x30 ,0x30 ,0x31 ,0x39 ,0x33 ,0x32 ,0x0D ,0x0A };	
//AT+SPPCONN=DC0D30001932，15号臂环的自动重连	
//uint8_t	conn_Master_19[25]={0x41 ,0x54 ,0x2B ,0x53 ,0x50 ,0x50 ,0x43 ,0x4F ,0x4E ,0x4E ,0x3D ,0x44 ,0x43 ,0x30 ,0x44 ,0x33 ,0x30 ,0x30 ,0x30 ,0x31 ,0x39 ,0x32 ,0x44 ,0x0D ,0x0A };	
//AT+SPPCONN=DC0D3000192D，15号臂环的自动重连		
//uint8_t	conn_Master_14[25]={0x41 ,0x54 ,0x2B ,0x53 ,0x50 ,0x50 ,0x43 ,0x4F ,0x4E ,0x4E ,0x3D ,0x44 ,0x43 ,0x30 ,0x44 ,0x33 ,0x30 ,0x30 ,0x30 ,0x31 ,0x39 ,0x33 ,0x41 ,0x0D ,0x0A };	
//AT+SPPCONN=DC0D3000193A，15号臂环的自动重连		
//uint8_t	conn_Master_7[25]={0x41 ,0x54 ,0x2B ,0x53 ,0x50 ,0x50 ,0x43 ,0x4F ,0x4E ,0x4E ,0x3D ,0x44 ,0x43 ,0x30 ,0x44 ,0x33 ,0x30 ,0x30 ,0x30 ,0x31 ,0x39 ,0x33 ,0x37 ,0x0D ,0x0A };	
//AT+SPPCONN=DC0D30001937，7号臂环的自动重连		
//uint8_t	conn_Master_1[25]={0x41, 0x54, 0x2B, 0x53, 0x50, 0x50, 0x43, 0x4F, 0x4E, 0x4E, 0x3D, 0x44, 0x43, 0x30, 0x44, 0x33, 0x30, 0x30, 0x30, 0x31, 0x39, 0x33, 0x30, 0x0D, 0x0A};	
//AT+SPPCONN=DC0D30001930，7号臂环的自动重连	
	
/* USER CODE END PV */

void SystemClock_Config(void);
/* USER CODE BEGIN PFP */
bool	IsUART1_Send_Idle();
/* USER CODE END PFP */

/**
  * @brief  The application entry point.
  * @retval int
  */
int main(void)
{
  /* MCU Configuration--------------------------------------------------------*/

  /* Reset of all peripherals, Initializes the Flash interface and the Systick. */
  HAL_Init();

  /* Configure the system clock */
  SystemClock_Config();

  /* USER CODE BEGIN SysInit */
  WKUP_init();
  /* USER CODE END SysInit */

  /* Initialize all configured peripherals */
  MX_GPIO_Init();
  MX_DMA_Init();
  MX_ADC1_Init();
  MX_I2C2_Init();
  MX_TIM3_Init();
  MX_TIM9_Init();
  MX_TIM10_Init();
  MX_TIM11_Init();
  MX_USART1_UART_Init();	
  MX_TIM4_Init();
  MX_TIM5_Init();
  /* Infinite loop */
  /* USER CODE BEGIN WHILE */

	HAL_ADC_Start_DMA(&hadc1,AD_Value,9);				//开启ADC转换


	Motor_Open();																//开电机
	Open_LED(0);																//开白色全灯
	HAL_Delay(300);															//稍作延时
	Motor_Close();															//关电机
	Li_battery = AD_Value[8];										//因为ADC采集Li_battery在主函数中执行，先提前采集一次数据
	HAL_Delay(50);															//稍作延时

	HAL_TIM_Base_Start_IT(&htim3);							//蓝牙闪烁htim 200ms/T
	HAL_TIM_Base_Start_IT(&htim9);							//状态判断htim	 90ms/T
	HAL_TIM_Base_Start_IT(&htim10);							//EMG采集htim	 2ms/T
	HAL_TIM_Base_Start_IT(&htim11);							//LED灯状态更新htim  50ms/T


  HAL_Delay(10);
//	DMP_init();																	//IMU初始化
  HAL_Delay(10);

  SystemFlag = 1;
	HAL_UART_Receive_IT(&huart1,RxBuffer,sizeof(RxBuffer));		//串口1接收中断		


//	HAL_UART_Transmit_DMA(&huart1, Uart_460800code, 16);
//	HAL_UART_Transmit_DMA(&huart1, conn_Master_3, 25);
//	HAL_Delay(1000);
//	HAL_UART_Transmit_DMA(&huart1, conn_Master_1, 25);
//	HAL_Delay(1000);

  while (1)
  {
		if(Motor_work_time!=0)
		{
			Motor_Open();
			HAL_Delay(Motor_work_time*100);			
			Motor_Close();	
			Motor_work_time = 0;			
		}

    /* USER CODE END WHILE */

    /* USER CODE BEGIN 3 */
  }
  /* USER CODE END 3 */
}

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
/* USER CODE BEGIN 4 */
void HAL_TIM_PeriodElapsedCallback(TIM_HandleTypeDef *htim)
{
	if(htim == &htim3)
	{//蓝牙指示灯工作定时器 500ms/T
		htim3_work_serve();
	}
	if(htim == &htim9)
	{//判断工作状态 10ms/T
		htim9_work_serve();
	}
	if(htim == &htim10)
	{//采集EMG 2ms  同时因为这个最高优先级的中断,也担负IMU的串口数据发送
	  
		
		
		get_ADCdata();	//获取9路ADC数据			//	test_adc_Data();
		while(IsUART1_Send_Idle() == true)
		HAL_UART_Transmit_DMA(&huart1, Emg_Data_Sent, 16);		//测试发17  只有EEG发16
	}//end of tim10
	if(htim == &htim11)
	{//电池状态判断 500ms
		htim11_work_serve();
	}
}

/*****************中断接收命令，trigger功能，CommandRecevFlag*********************/
void HAL_UART_RxCpltCallback(UART_HandleTypeDef *huart)
{
	if(huart == &huart1)
	{
		//定长解析
		if((RxBuffer[0]==0xCC)&&(RxBuffer[1]==0xDD))
		{
			if(RxBuffer[2] == 0xFF)
			{
				
			}
			else if(RxBuffer[2] == 0xEE)
			{//将time传递给电机震动部分
				Motor_work_time = RxBuffer[3];
			}			
		}	
		HAL_UART_Receive_IT(&huart1,RxBuffer,sizeof(RxBuffer));		//串口1接收中断				
	}
}


//串口空闲判断函数
bool	IsUART1_Send_Idle()
{
	if(HAL_UART_GetState(&huart1) != HAL_UART_STATE_BUSY_TX)
	{//首先确定发送不处于忙碌状态
		if(__HAL_UART_GET_FLAG(&huart1, UART_FLAG_TC) == SET)
		{//其次确定发送旗标位已经复位
			return true;
		}	
	}
	return false;
}
/* USER CODE END 4 */
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
